hirotaka42/KiCad_UnoTypeC/Hardware/KiCad7xx_UnoTypeC/_PNG/KiCad7xx_UnoTypeC_Back.png

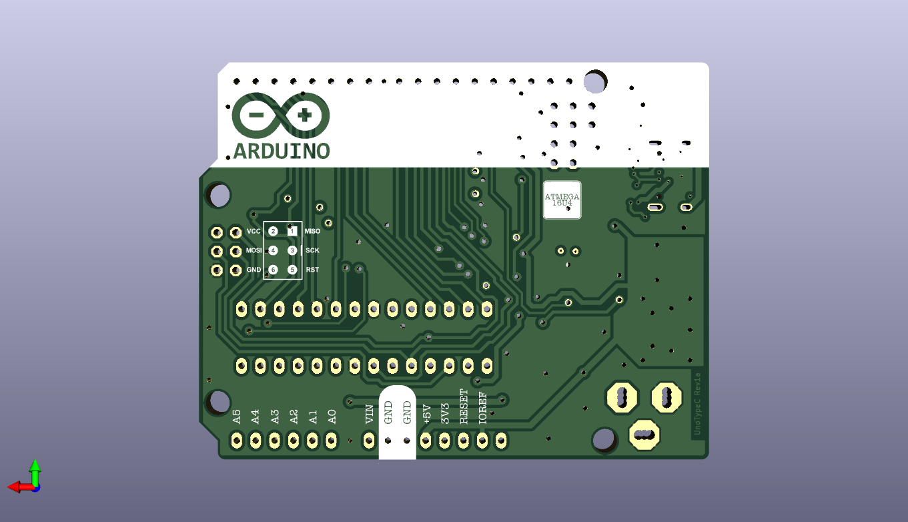
Hardware/KiCad7xx_UnoTypeC/_PNG/KiCad7xx_UnoTypeC_Back.png
