hirotaka42/KiCad_UnoTypeC/Hardware/KiCad7xx_UnoTypeC/_PNG/PCB_Back.png

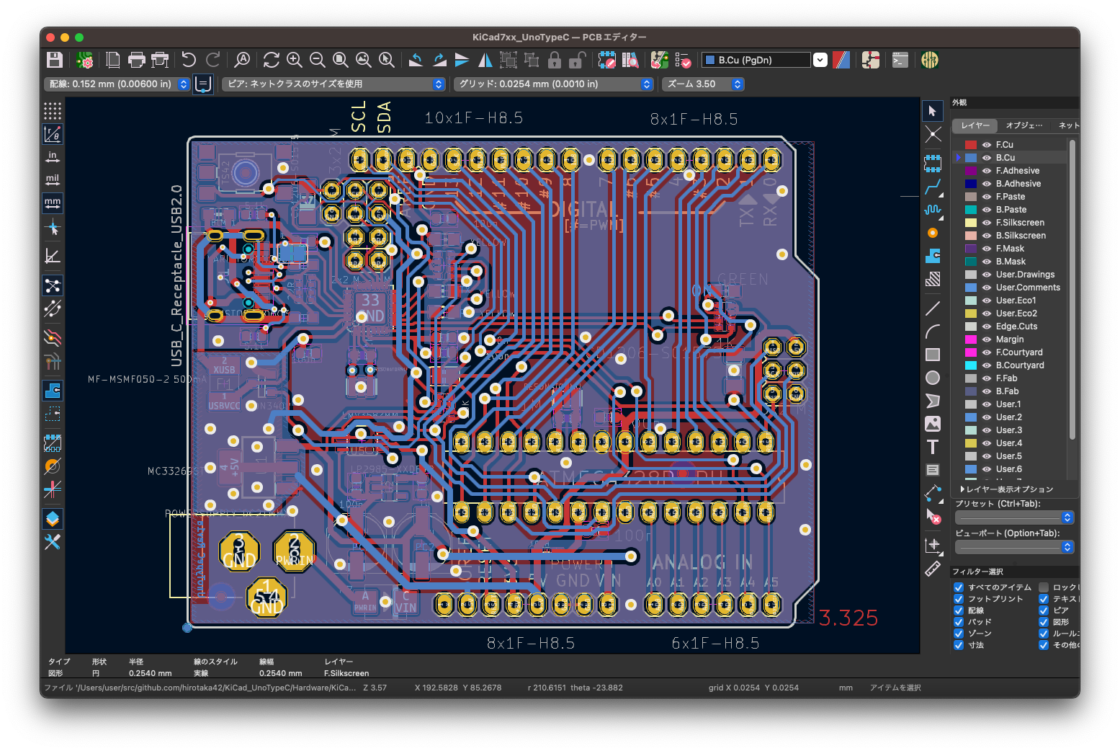
Hardware/KiCad7xx_UnoTypeC/_PNG/PCB_Back.png
