hirotaka42/KiCad_UnoTypeC/Hardware/KiCad7xx_UnoTypeC/_PNG/PCB_Front.png

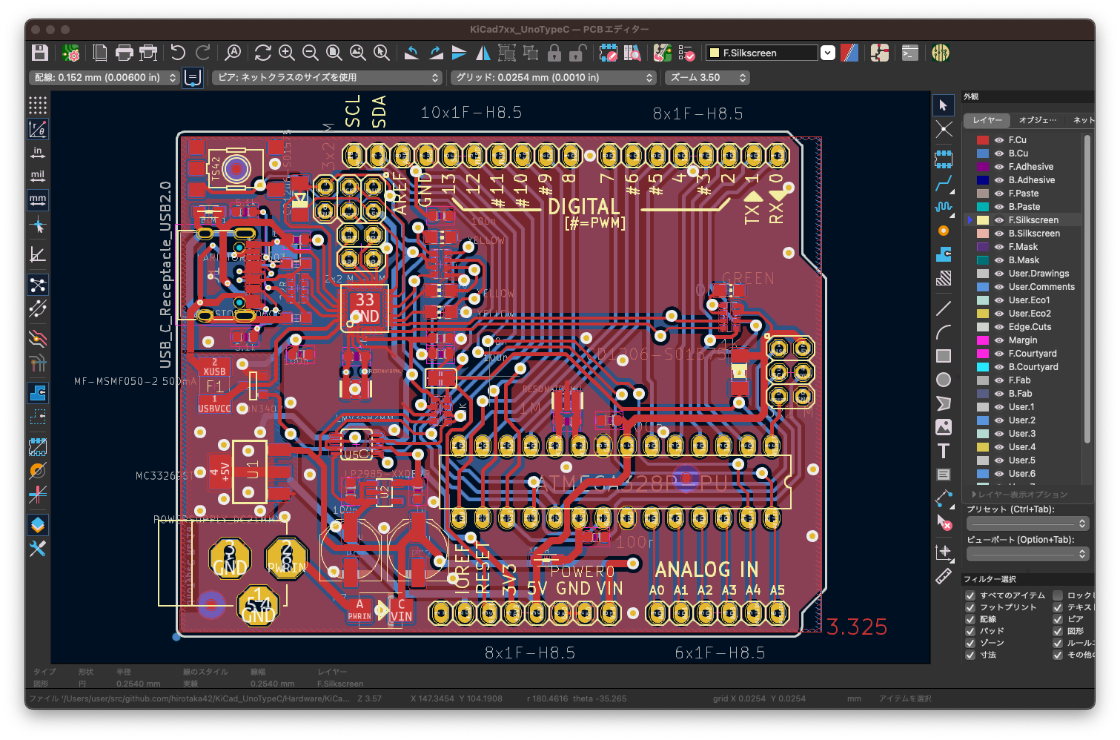
Hardware/KiCad7xx_UnoTypeC/_PNG/PCB_Front.png
