hirotaka42/KiCad_UnoTypeC/Hardware/KiCad7xx_UnoTypeC_SMD/_Adobe/シルク_Front_Rev1c.png

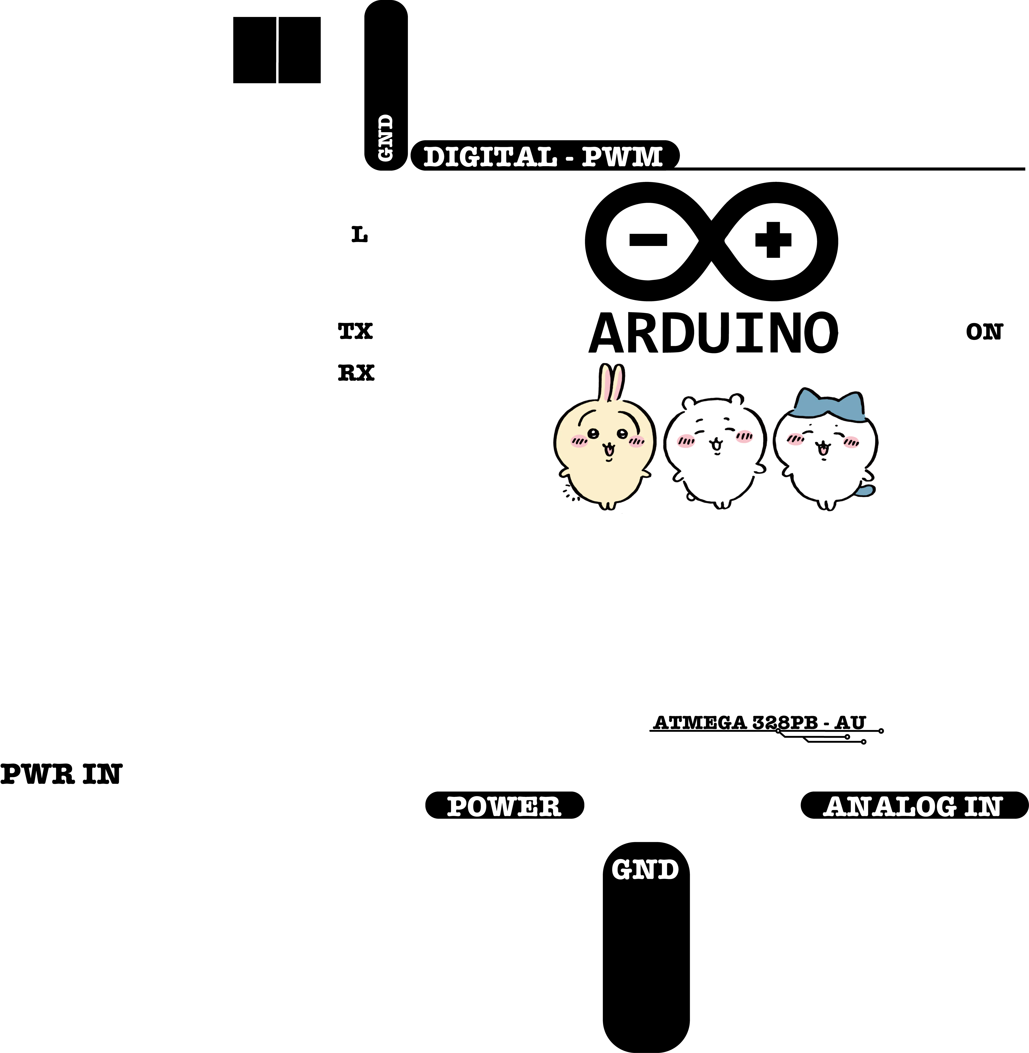
Hardware/KiCad7xx_UnoTypeC_SMD/_Adobe/シルク_Front_Rev1c.png
