hirotaka42/KiCad_UnoTypeC/Hardware/KiCad7xx_UnoTypeC_SMD/_PNG/KiCad7xx_UnoTypeC_SMD_Front.png

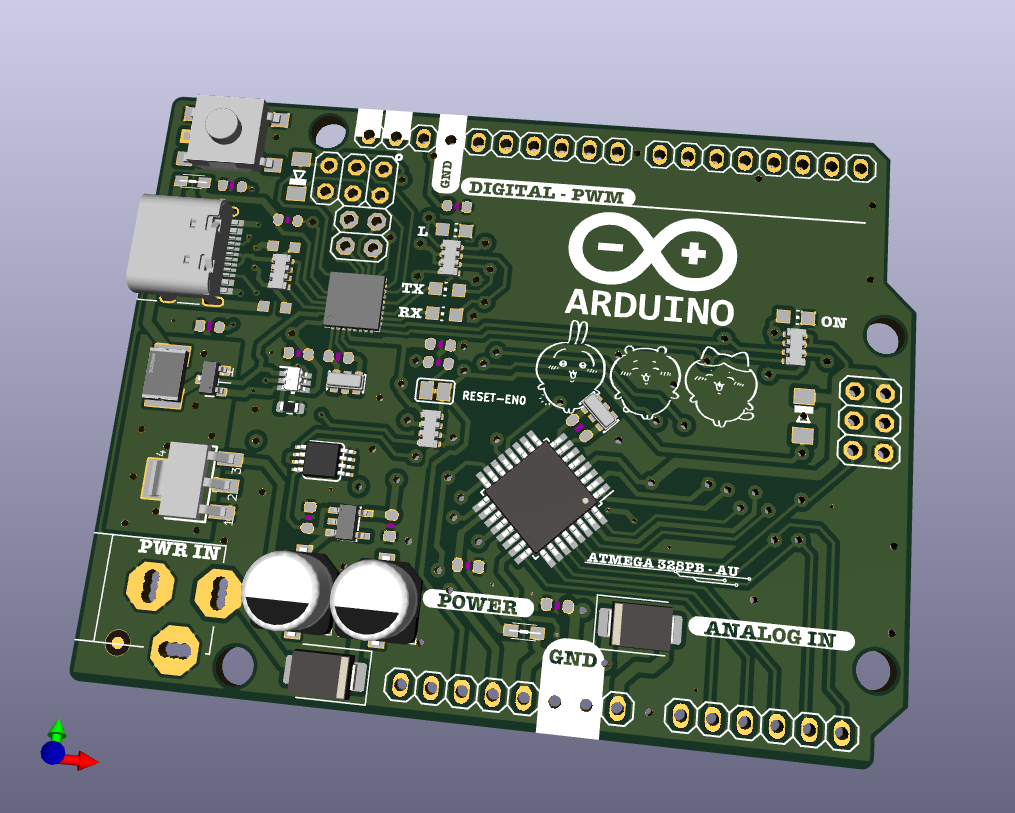
Hardware/KiCad7xx_UnoTypeC_SMD/_PNG/KiCad7xx_UnoTypeC_SMD_Front.png
