hirotaka42/KiCad_UnoTypeC/Hardware/KiCad7xx_UnoTypeC_SMD/_Adobe/material/arduino-bord.png

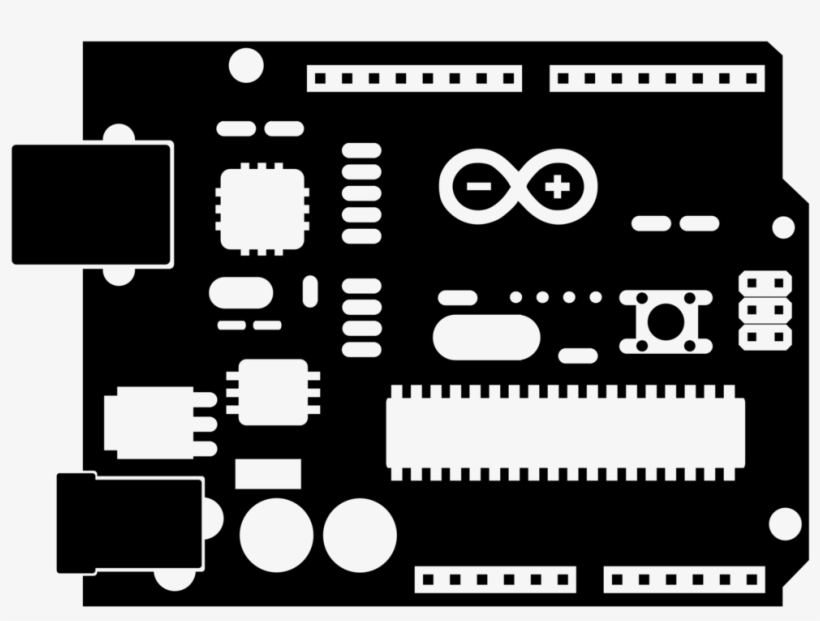
Hardware/KiCad7xx_UnoTypeC_SMD/_Adobe/material/arduino-bord.png
