hirotaka42/KiCad_UnoTypeC/(threads)

Thread 2 (2023-06-02):

KiCadプロジェクトへ変換

hirotaka42, 2023-06-02:
1.KiCadプロジェクトへ変換
2.KiCad用のパーツデータを追加
3.KiCadプロジェクトでの互換状態へ
4.KiCad版で公式Unoのガーバデータを出力

hirotaka42, 2023-06-02:
# 完了
1.KiCadプロジェクトへ変換

# 未完了
2.KiCad用のパーツデータを追加
   - フットプリントとシンボルデータの出力
3.KiCadプロジェクトでの互換状態へ
   - フットプリント上にパーツデータが3D表示されている状態
   - エレクトリカルチェックをパスできる
4.KiCad版で公式Unoのガーバデータを出力
   - シルクは未定でOK

hirotaka42, 2023-06-03:
# 未完了

4.KiCad版で公式Unoのガーバデータを出力
   - シルクは未定でOK

# 完了
1.KiCadプロジェクトへ変換
2.KiCad用のパーツデータを追加
   - フットプリントとシンボルデータの出力

3.KiCadプロジェクトでの互換状態へ
   - >フットプリント上にパーツデータが3D表示されている状態
   - エレクトリカルチェックをパスできる

hirotaka42, 2023-06-03:
# 未完了
4.KiCad版で公式Unoのガーバデータを出力
- シルクは未定でOK

ガーバーデータはこのissueでは作成していません。
Type-C基板を設計した際にReleaseか何かでまとめようかと考えています。

Closed 2023-06-03.

Thread 6 (2023-06-03):

UNOSMD_V3のTypeC基板作成

hirotaka42, 2023-06-03:
# UNOSMD_V3のTypeC基板作成

1. UNOSMD_V3(SMD(328P-AU)版)のコネクタをTypeCへ変更
2. 回路図の全体的な整理

# 前提条件
部品は可能な限り同じ構成で作成

# 変更予定
### コネクタの変更
- `USB Type-B (USB-Bコネクタ)`→`USB Type-C (USB-Cコネクタ)`

### 電源回路の見直し(逆流電流防止)

1.理想ダイオード回路の採用
2.保護ダイオードの追加
3.DCジャックを背の低いものへ変更

参考サイト
https://geekyfab.com/entry/making-universalduino

hirotaka42, 2023-06-03:
## 変更点
回路は変更せずに、TypeCコネクタを追加しました。
Type-C端子は本体が取れやすい為、半田で固定できるタイプを選択。

DX07S016JA1R1500
データシート→`SJ121836.pdf`
https://www.digikey.jp/ja/products/detail/jae-electronics/DX07S016JA1R1500/11585731

## PIN ASSIGNMENT (P.C.B PADS)

|Pad No. |1 |2 |3 |4 |5 |6 |7 |8 |9 |10 |11 |12 |
|----|----|----|----|----|----|----|----|----|----|----|----|----|
|Pin No. NAME |A1/B12 |A4/B9 |A5 |B8 |B7 | A6 |B6 |A7 | B5|A8 |B4/A9 | A12/B1 |
|SIGNAL NAME|GND |Vbus | CC1 |SBU2 |D- |D+ | D+ |D- |CC2 |SBU1 |Vbus|GND|

## 注意点
TypeCのピンアサインの並びが違うようです。
設計後確認をお願いします。

hirotaka42, 2023-06-03:
# 結論
今回はコネクタの変更のみを行いました。
未変更箇所は別プロジェクトで作成してください。
- >回路変更なしのコネクタのみ変更←今回作成したのはこっち
- 逆流防止回路を入れた修正回路版←次回作成するやつ

# 未変更

電源回路の見直し(逆流電流防止)
1.理想ダイオード回路の採用
2.保護ダイオードの追加
3.DCジャックを背の低いものへ変更

参考サイト
https://geekyfab.com/entry/making-universalduino

Closed 2023-06-03.

Thread 10 (2023-06-04):

ATMEGA328P-AU版の基板を作成

hirotaka42, 2023-06-04:
# 概要
ATMEGA328P-AU版の基板を作成
`KiCad7xx_UNOSMD_V3_TypeC_X302`

# 理由
- `KiCad7xx_UNOSMD_V3_TypeC`
- `KiCad7xx_UNOSMD_V3_TypeC_X301`

上記2枚の基板はメインコアに`ATMEGA328P-MUR`を使用しています。
ですが、`MURパッケージ`は現在(2023/06/05)入手性が非常に悪いです。
その為、秋月電子やLCSCなどで入手しやすい`AUパッケージ`版を採用します。

# 参考

|販売元|リンク|
|----|----|
|LCSC.com|[C14877](https://www.lcsc.com/product-detail/Microcontroller-Units-MCUs-MPUs-SOCs_Microchip-Tech-ATMEGA328P-AU_C14877.html)|
|秋月電子|[I-04386](https://akizukidenshi.com/catalog/g/gI-04386/)|

Closed 2023-06-04.

Thread 12 (2023-06-04):

ATMEGA328P-AU版の基板X302をベースにGrove端子を追加した基板X303を作成

hirotaka42, 2023-06-04:
# 概要
I2CのGrove端子を追加した基板X303を作成

# 前提条件
ATMEGA328P-AU版の基板[KiCad7xx_UNOSMD_V3_TypeC_X302](https://github.com/hirotaka42/KiCad_UnoTypeC/tree/dev/Hardware/KiCad7xx_UNOSMD_V3_TypeC_X302)をベースに、新規プロジェクトX303を作成する。

# 変更予定
ATMEGA328P-AU版の基板X302をベースに、
- マイコン`ATMEGA328P-AU`の未使用端子2Pinを使用したGrove端子1つ
- I2CのGrove端子1つ

合計2つのGrove端子を追加した基板X303を作成する。
最低条件として`I2CのGrove端子1つ`の実装を目標とする。

hirotaka42, 2023-06-05:
GroveコネクタのKiCadデータは以下で配布されています。
- https://github.com/orgs/Seeed-Studio/repositories?q=opl&type=all&language=&sort=
- [OPL_Connector.pretty](https://github.com/Seeed-Studio/OPL_Kicad_Library/tree/master/Seeed_Fusion_PCBA_OPL_Component_Library_for_KiCad/OPL_Connector.pretty)

X302をベースにした2層基板データではGroveコネクタを配線するスペースがありません。
その為、4層基板での設計でなければ厳しいです。
よって本issueは4層基板を設計する際に再度オープンにしてください。

該当ブランチを削除し、本issueはCloseとします。

# 該当ブランチ
- [feature-#12_CreatBoardX303WithAdditional-I2C-GrovePins](https://github.com/hirotaka42/KiCad_UnoTypeC/tree/feature-%2312_CreatBoardX303WithAdditional-I2C-GrovePins)

hirotaka42, 2023-06-05:
Groveコネクタのピンアサイン
信号名(ex,I2C) | GROVE端子 | SeedStudio版ケーブル色 | M5Stack版ケーブル色
-- | -- | -- | --
SCL | Pin1 | 黃 | 白
SDA | Pin2 | 白 | 黄
(電源/VDD) | VDD | Pin3 | 赤
(電源/GND) | GND | Pin4 | 黒

Closed 2023-06-05.

Thread 8 (2023-06-04):

UNOSMD_V3に逆流防止回路を追加する

hirotaka42, 2023-06-04:
# UNOSMD_V3の逆流防止を入れた修正回路作成

Add backflow prevention circuit to UNOSMD_V3.

# 前提条件
[KiCad7xx_UNOSMD_V3_TypeC](https://github.com/hirotaka42/KiCad_UnoTypeC/tree/dev/Hardware/KiCad7xx_UNOSMD_V3_TypeC)をベースに本目的`KiCad7xx_UNOSMD_V3_TypeC_Kai301`を作成

回路変更は以下２つを最低条件とする。
1.理想ダイオード回路の採用
2.保護ダイオードの追加

# 変更予定

## 電源回路の見直し(逆流電流防止)

1.理想ダイオード回路の採用
2.保護ダイオードの追加
3.DCジャックを背の低いものへ変更

参考サイト
https://geekyfab.com/entry/making-universalduino

# 関連issue
#6  このissueの取り残しを回収します。

Closed 2023-06-04.
