hirotaka42/KiCad_UnoTypeC/Hardware/Make/KiCad7xx_UnoTypeC.pdf

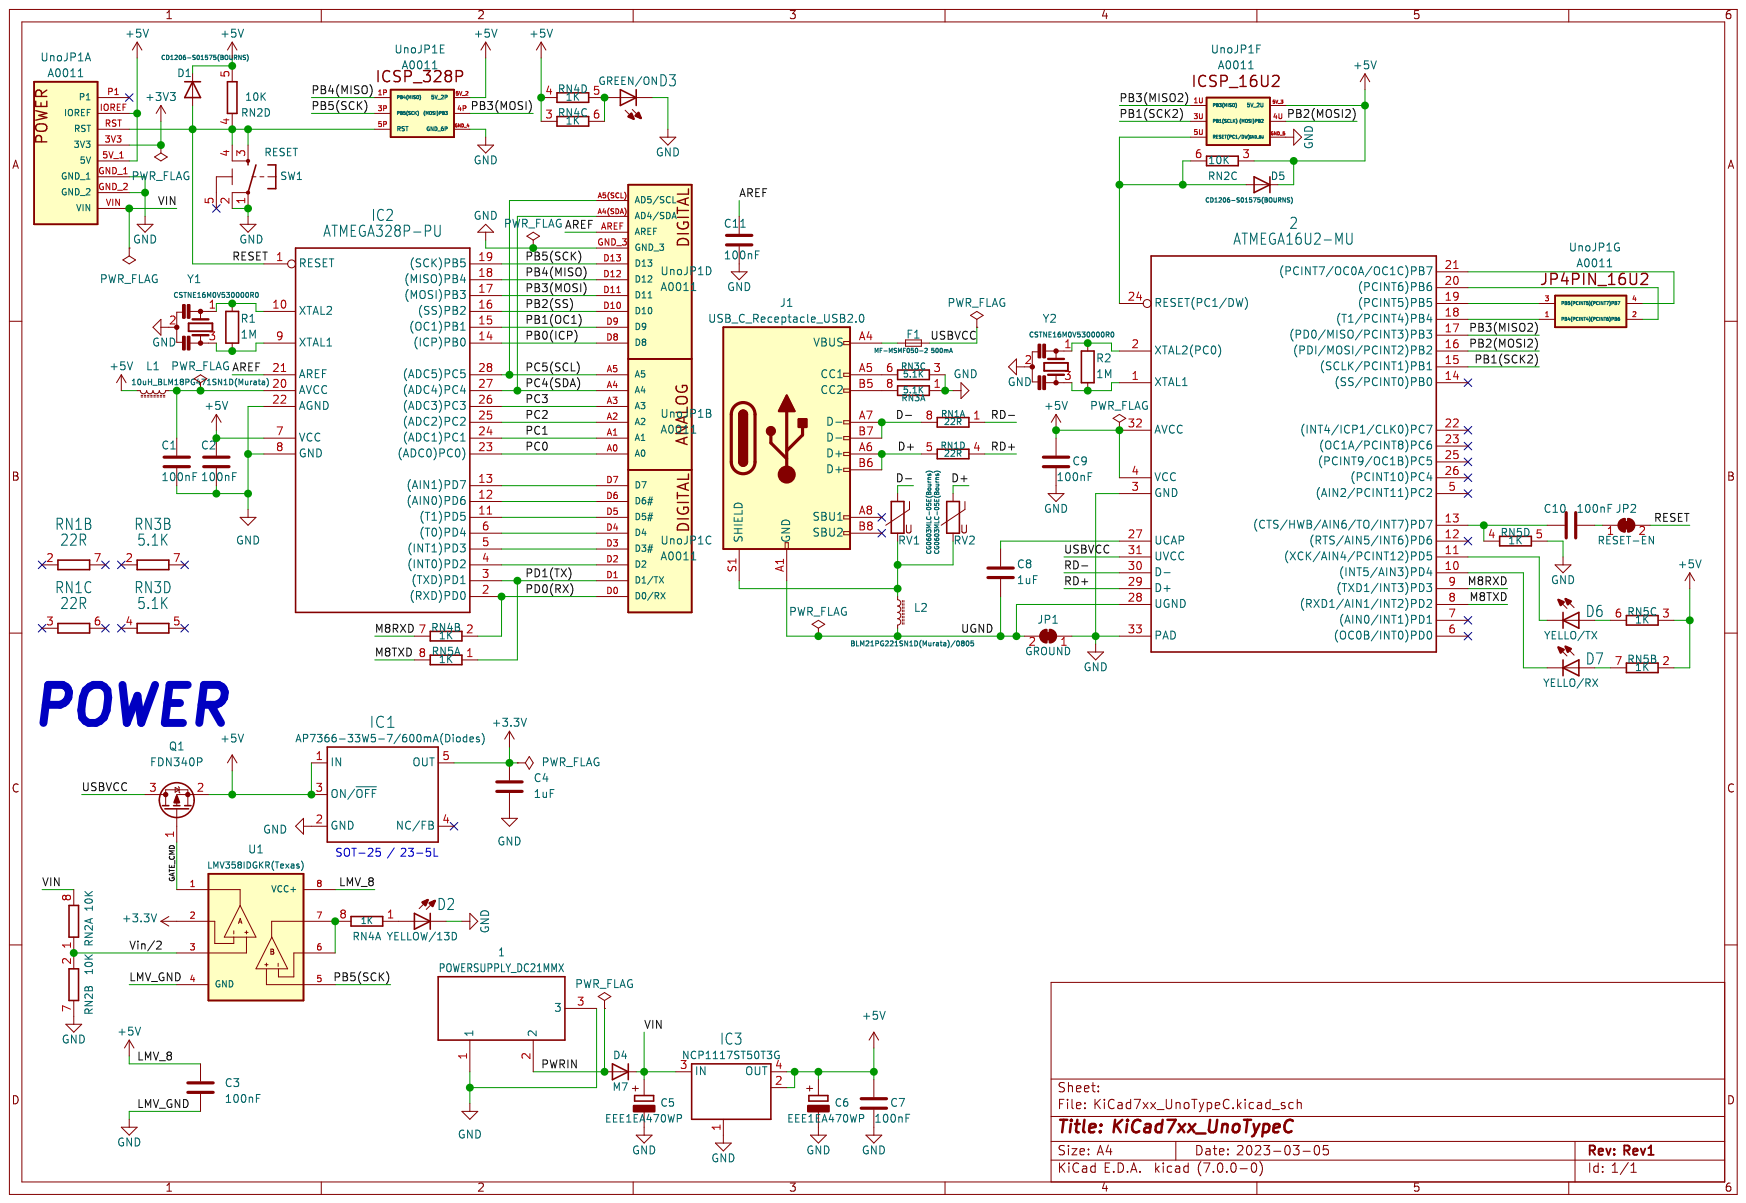
[picture p13: page 1]
