hirotaka42/KiCad_UnoTypeC/Hardware/KiCad7xx_UnoTypeC/_Sch/KiCad7xx_UnoTypeC.pdf

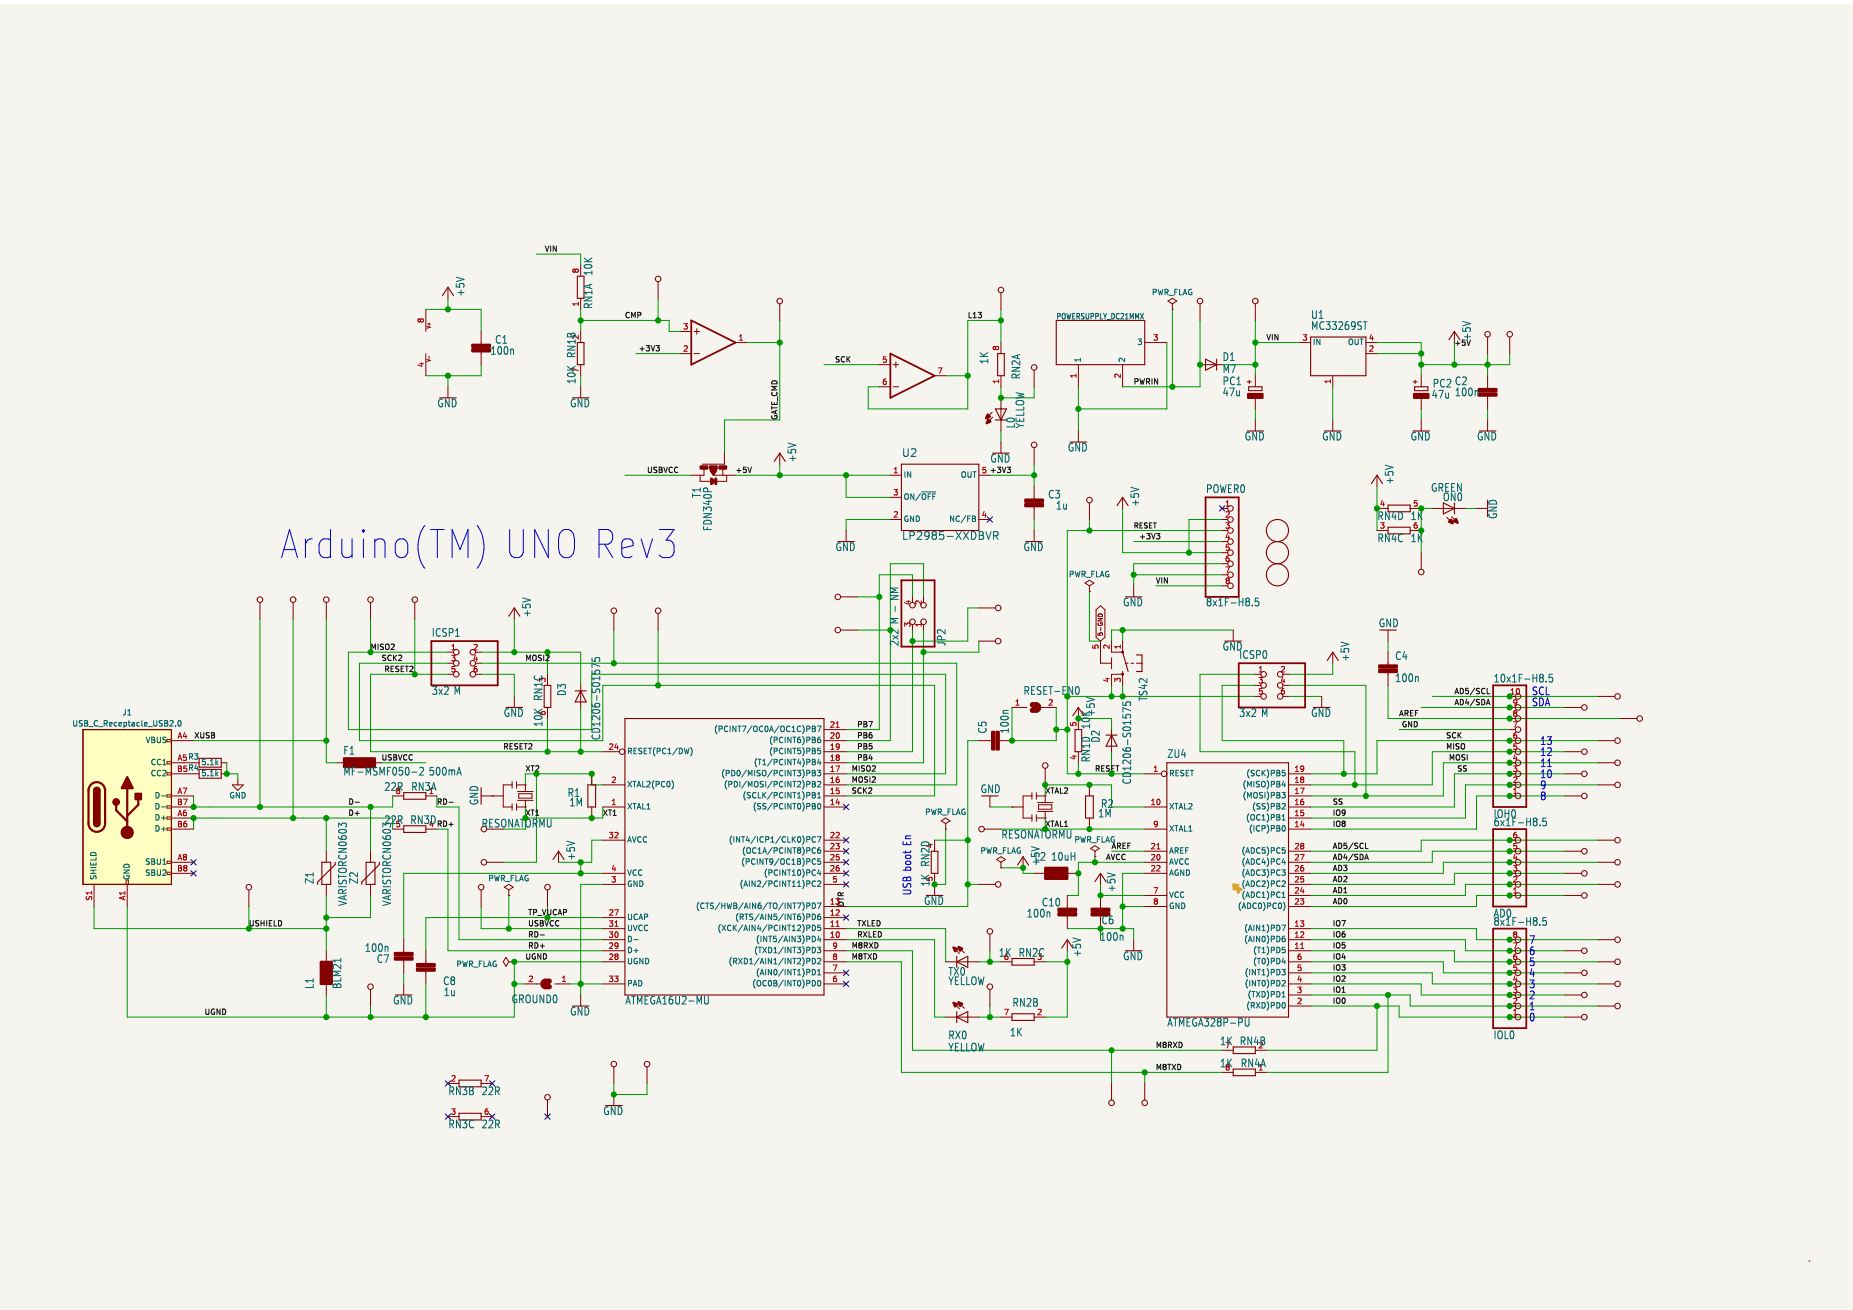
[picture p14: page 1]
