hirotaka42/KiCad_UnoTypeC/Hardware/KiCad7xx_UnoTypeC_SMD/KiCad7xx_UnoTypeC_SMD.kicad_pcb

## KiCad design Hardware/KiCad7xx_UnoTypeC_SMD/KiCad7xx_UnoTypeC_SMD.kicad_pcb (2023-03-10)

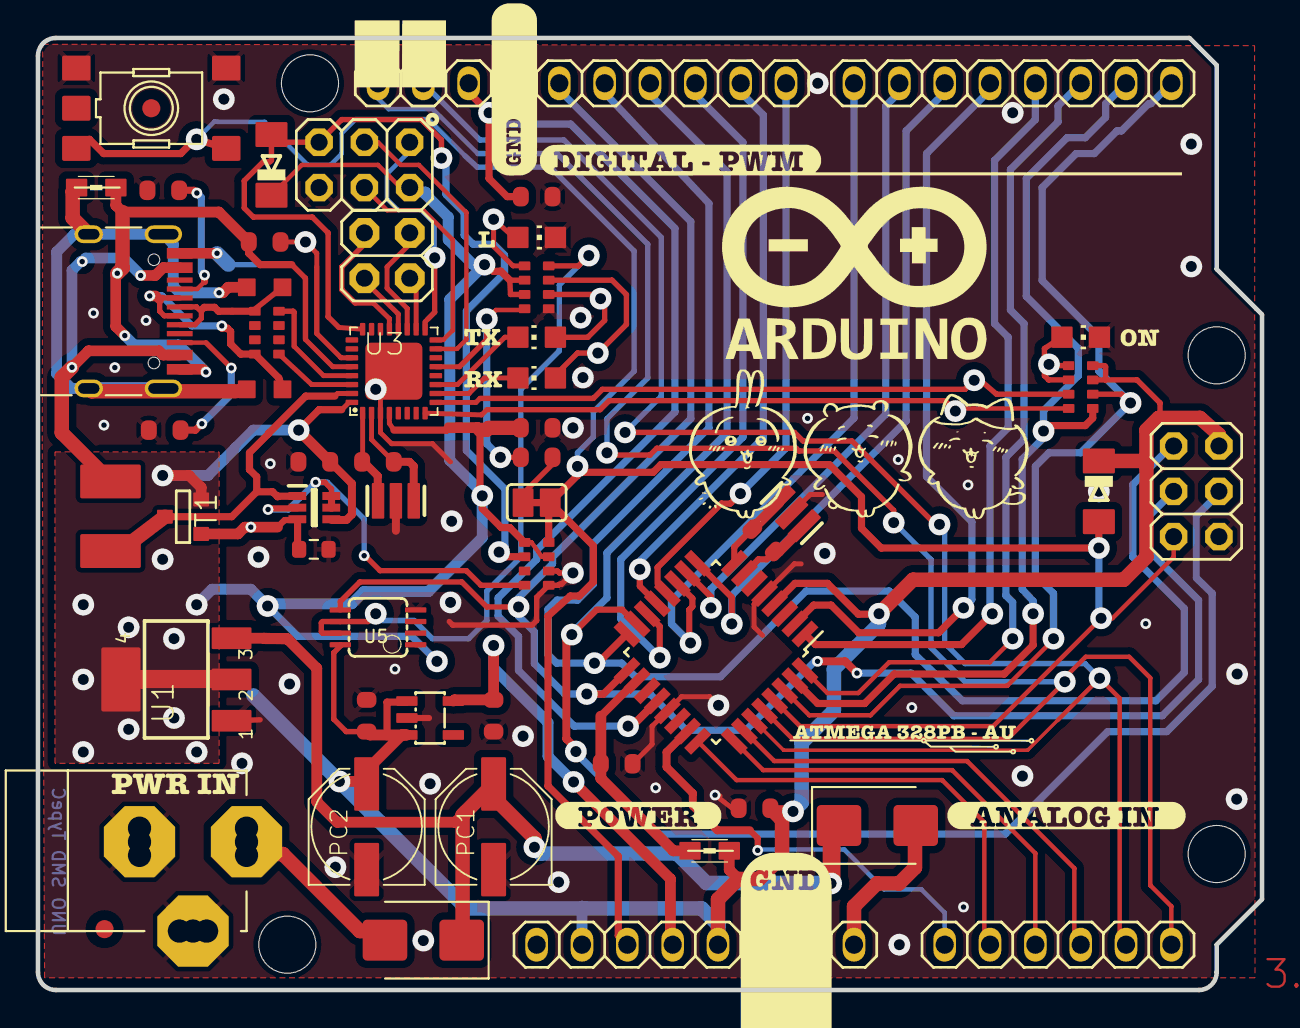
[picture p15: board KiCad7xx_UnoTypeC_SMD.kicad_pcb from above]

Board: 2 copper layers, 68.6 x 53.3 mm, 73 parts (1 on the bottom side), 64 nets.

Parts:
C1, C2, C4, C5, C6, C7: 100n; C0603-ROUND
C3, C8: 1u; C0603-ROUND
C9: 100nF; C0603-ROUND
D1, D4: SS54B (FOSAN); D_SMB
D2, D3: CD1206-S01575; MINIMELF
F1: MF-MSMF110/16-2A; L1812
FD1, FD3: FIDUCIAL-1.5MM; FD-1-1.5
GROUND0: SJ
H1, H2, H3, H4: MountingHole; MountingHole_3.2mm_M3_ISO14580
ICSP0, ICSP1: 3x2 M; 2X03
J1: -; 1X14-CUSTOM
J2: PINHD-1X18; 1X18-CUSTOM
J3: USB_C_Receptacle_USB2.0; USB_C_Receptacle_HRO_TYPE-C-31-M-12
JP2: 2x2 M-NM; 2X02
L0: YELLOW; CHIP-LED0805
L1: BLM21; 0805
L2: 10uH; 0805
ON0: GREEN; CHIP-LED0805
ORIGIN0: TP_SP; TP-SP
PC1, PC2: 47u; PANASONIC_D
R1, R2: 1M; R0603-ROUND
R3, R4: 5.1k; R0603-ROUND
R5: 47K; R_0603_1608Metric
RESET0: TS42
RESET-EN0: SJ
RN1: 10K; CAY16
RN2, RN4: 1K; CAY16
RN3: 22R; CAY16
RX0: YELLOW; CHIP-LED0805
T1: PMOS/FDN340P(onsemi)/2A; SOT-23
TP_5V1: TP_SP; TP-SP
TP_DTR0: TP_SP; TP-SP
TP_LCMD0: TP_SP; TP-SP
TP_LL0: TP_SP; TP-SP
TP_MISO2: TP_SP; TP-SP
TP_MOSI2: TP_SP; TP-SP
TP_ONL0: TP_SP; TP-SP
TP_RESET2: TP_SP; TP-SP
TP_RX0: TP_SP; TP-SP
TP_RXL0: TP_SP; TP-SP
TP_SCK2: TP_SP; TP-SP
TP_TX0: TP_SP; TP-SP
TP_TXL0: TP_SP; TP-SP
TP_VUCAP0: TP_SP; TP-SP
TX0: YELLOW; CHIP-LED0805
U1: MC33269ST; SOT223
U2: LP2985-XXDBVR; SOT23-DBV
U3: ATMEGA16U2; ATMEL_QFN32
U4: ATmega328PB-A; TQFP-32_7x7mm_P0.8mm
U5: LMV358IDGKR; MSOP08
U6: BCM857BS; SOT65P210X110-6N
X1: POWERSUPPLY_DC21MMX; POWERSUPPLY_DC-21MM
Y1, Y2: RESONATORMU; RESONATOR
Z1, Z2: VARISTORCN0603; CT_CN0603

Connections:
+3.3V: C3.2, J1.4, U2.5 (OUT)
+5V: C1.2, C2.2, C6.2, C7.1, D2.C, D3.C, ICSP0.2, ICSP1.2, J1.2, J1.5, L2.1, PC2.+, RN1.3 (1), RN1.5 (2), RN2.2 (1), RN2.3 (1), RN4.3 (1), RN4.4 (1), T1.2 (S), TP_5V1.X (TESTP), U1.2 (OUT@1), U1.4 (OUT), U2.1 (IN), U2.3 (ON/~OFF), U3.4 (VCC), U3.32 (AVCC), U4.4 (VCC), U5.8 (VCC+), U6.4
/A0: J1.9, U4.23 (PC0)
/A1: J1.10, U4.24 (PC1)
/A2: J1.11, U4.25 (PC2)
/A3: J1.12, U4.26 (PC3)
/A4/SDA: J1.13, J2.17, U4.27 (PC4)
/A5/SCL: J1.14, J2.18, U4.28 (PC5)
/AREF: C4.2, J2.16, U4.20 (AREF)
/AVCC: C9.1, L2.2, U4.18 (AVCC)
/D+: J3.A6 (D+), J3.B6 (D+), RN3.5 (2), Z1.1
/D-: J3.A7 (D-), J3.B7 (D-), RN3.8 (2), Z2.1
/DTR: C5.1, RN2.4 (1), TP_DTR0.X (TESTP), U3.13 ((CTS/HWB/AIN6/TO/INT7)PD7)
/IO0: J2.1, RN4.2 (1), U4.30 (PD0)
/IO1: J2.2, RN4.1, U4.31 (PD1)
/IO2: J2.3, U4.32 (PD2)
/IO3: J2.4, U4.1 (PD3)
/IO4: J2.5, U4.2 (PD4)
/IO5: J2.6, U4.9 (PD5)
/IO6: J2.7, U4.10 (PD6)
/IO7: J2.8, U4.11 (PD7)
/IO8: J2.9, U4.12 (PB0)
/IO9: J2.10, U4.13 (PB1)
/L13: RN2.8 (2), TP_LCMD0.X (TESTP), U5.6, U5.7
/M8RXD: RN4.7 (2), TP_RX0.X (TESTP), U3.9 ((TXD1/INT3)PD3)
/M8TXD: RN4.8 (2), TP_TX0.X (TESTP), U3.8 ((RXD1/AIN1/INT2)PD2)
/MISO: ICSP0.1, J2.13, U4.16 (PB4)
/MISO2: ICSP1.1, TP_MISO2.X (TESTP), U3.17 ((PD0/MISO/PCINT3)PB3)
/MOSI: ICSP0.4, J2.12, U4.15 (PB3)
/MOSI2: ICSP1.4, TP_MOSI2.X (TESTP), U3.16 ((PDI/MOSI/PCINT2)PB2)
/PB4: JP2.1, U3.18 ((T1/PCINT4)PB4)
/PB5: JP2.3, U3.19 ((PCINT5)PB5)
/PB6: JP2.2, U3.20 ((PCINT6)PB6)
/PB6/XTAL1: R2.1, U4.7 (XTAL1/PB6), Y2.3
/PB7: JP2.4, U3.21 ((PCINT7/OC0A/OC1C)PB7)
/PB7/XTAL2: R2.2, U4.8 (XTAL2/PB7), Y2.1
/PC6/RESET: C5.2, D2.A, ICSP0.5, J1.3, RESET0.3, RESET0.4, RESET-EN0.1, RESET-EN0.2, RN1.4 (1), U4.29 (~RESET/PC6)
/PWRIN: D1.2 (A), X1.1
/RD+: RN3.4 (1), U3.29 (D+)
/RD-: RN3.1, U3.30 (D-)
/RESET2: D3.A, ICSP1.5, RN1.6 (2), TP_RESET2.X (TESTP), U3.24 (RESET(PC1/DW))
/RXLED: RX0.C, U3.10 ((INT5/AIN3)PD4)
/SCK: ICSP0.3, J2.14, U4.17 (PB5), U5.5
/SCK2: ICSP1.3, TP_SCK2.X (TESTP), U3.15 ((SCLK/PCINT1)PB1)
/SS: J2.11, U4.14 (PB2)
/TP_VUCAP: C8.1, TP_VUCAP0.X (TESTP), U3.27 (UCAP)
/TXLED: TX0.C, U3.11 ((XCK/AIN4/PCINT12)PD5)
/UGND: C8.2, GROUND0.2, J3.A1 (GND), J3.A12 (GND), J3.B1 (GND), J3.B12 (GND), L1.1, U3.28 (UGND)
/USBVCC: F1.1, T1.1 (D), U3.31 (UVCC), U6.1
/USHIELD: J3.S1 (SHIELD), L1.2, Z1.2, Z2.2
/VIN: D4.2 (A), J1.8
/XT1: R1.1, U3.1 (XTAL1), Y1.3
/XT2: R1.2, U3.2 (XTAL2(PC0)), Y1.1
/XUSB: F1.2, J3.A4 (VBUS), J3.A9 (VBUS), J3.B4 (VBUS), J3.B9 (VBUS)
GND: C1.1, C2.1, C3.1, C4.1, C6.1, C7.2, C9.2, GROUND0.1, ICSP0.6, ICSP1.6, J1.6, J1.7, J2.15, L0.C, ON0.C, PC1.-, PC2.-, R3.1, R4.1, R5.2, RESET0.1, RESET0.2, RN1.1, RN2.5 (2), U1.1 (GND/ADJ), U2.2 (GND), U3.3 (GND), U3.EXP (PAD), U4.5 (GND), U4.21 (GND), U5.4 (GND), X1.2, X1.3, Y1.2, Y2.2
unnamed: J3.A5 (CC1), R3.2
unnamed: J3.B5 (CC2), R4.2
unnamed: RN1.8 (2), U6.2, U6.5, U6.6
unnamed: RN2.7 (2), RX0.A, TP_RXL0.X (TESTP)
unnamed: RN2.6 (2), TP_TXL0.X (TESTP), TX0.A
unnamed: ON0.A, RN4.5 (2), RN4.6 (2), TP_ONL0.X (TESTP)
unnamed: R5.1, T1.3 (G), U6.3
unnamed: L0.A, RN2.1, TP_LL0.X (TESTP)
VCC: D1.1 (K), D4.1 (K), PC1.+, U1.3 (IN)
