hirotaka42/KiCad_UnoTypeC/Hardware/KiCad7xx_UnoTypeC/KiCad7xx_UnoTypeC.kicad_pcb

## KiCad design Hardware/KiCad7xx_UnoTypeC/KiCad7xx_UnoTypeC.kicad_pcb (2023-03-07)

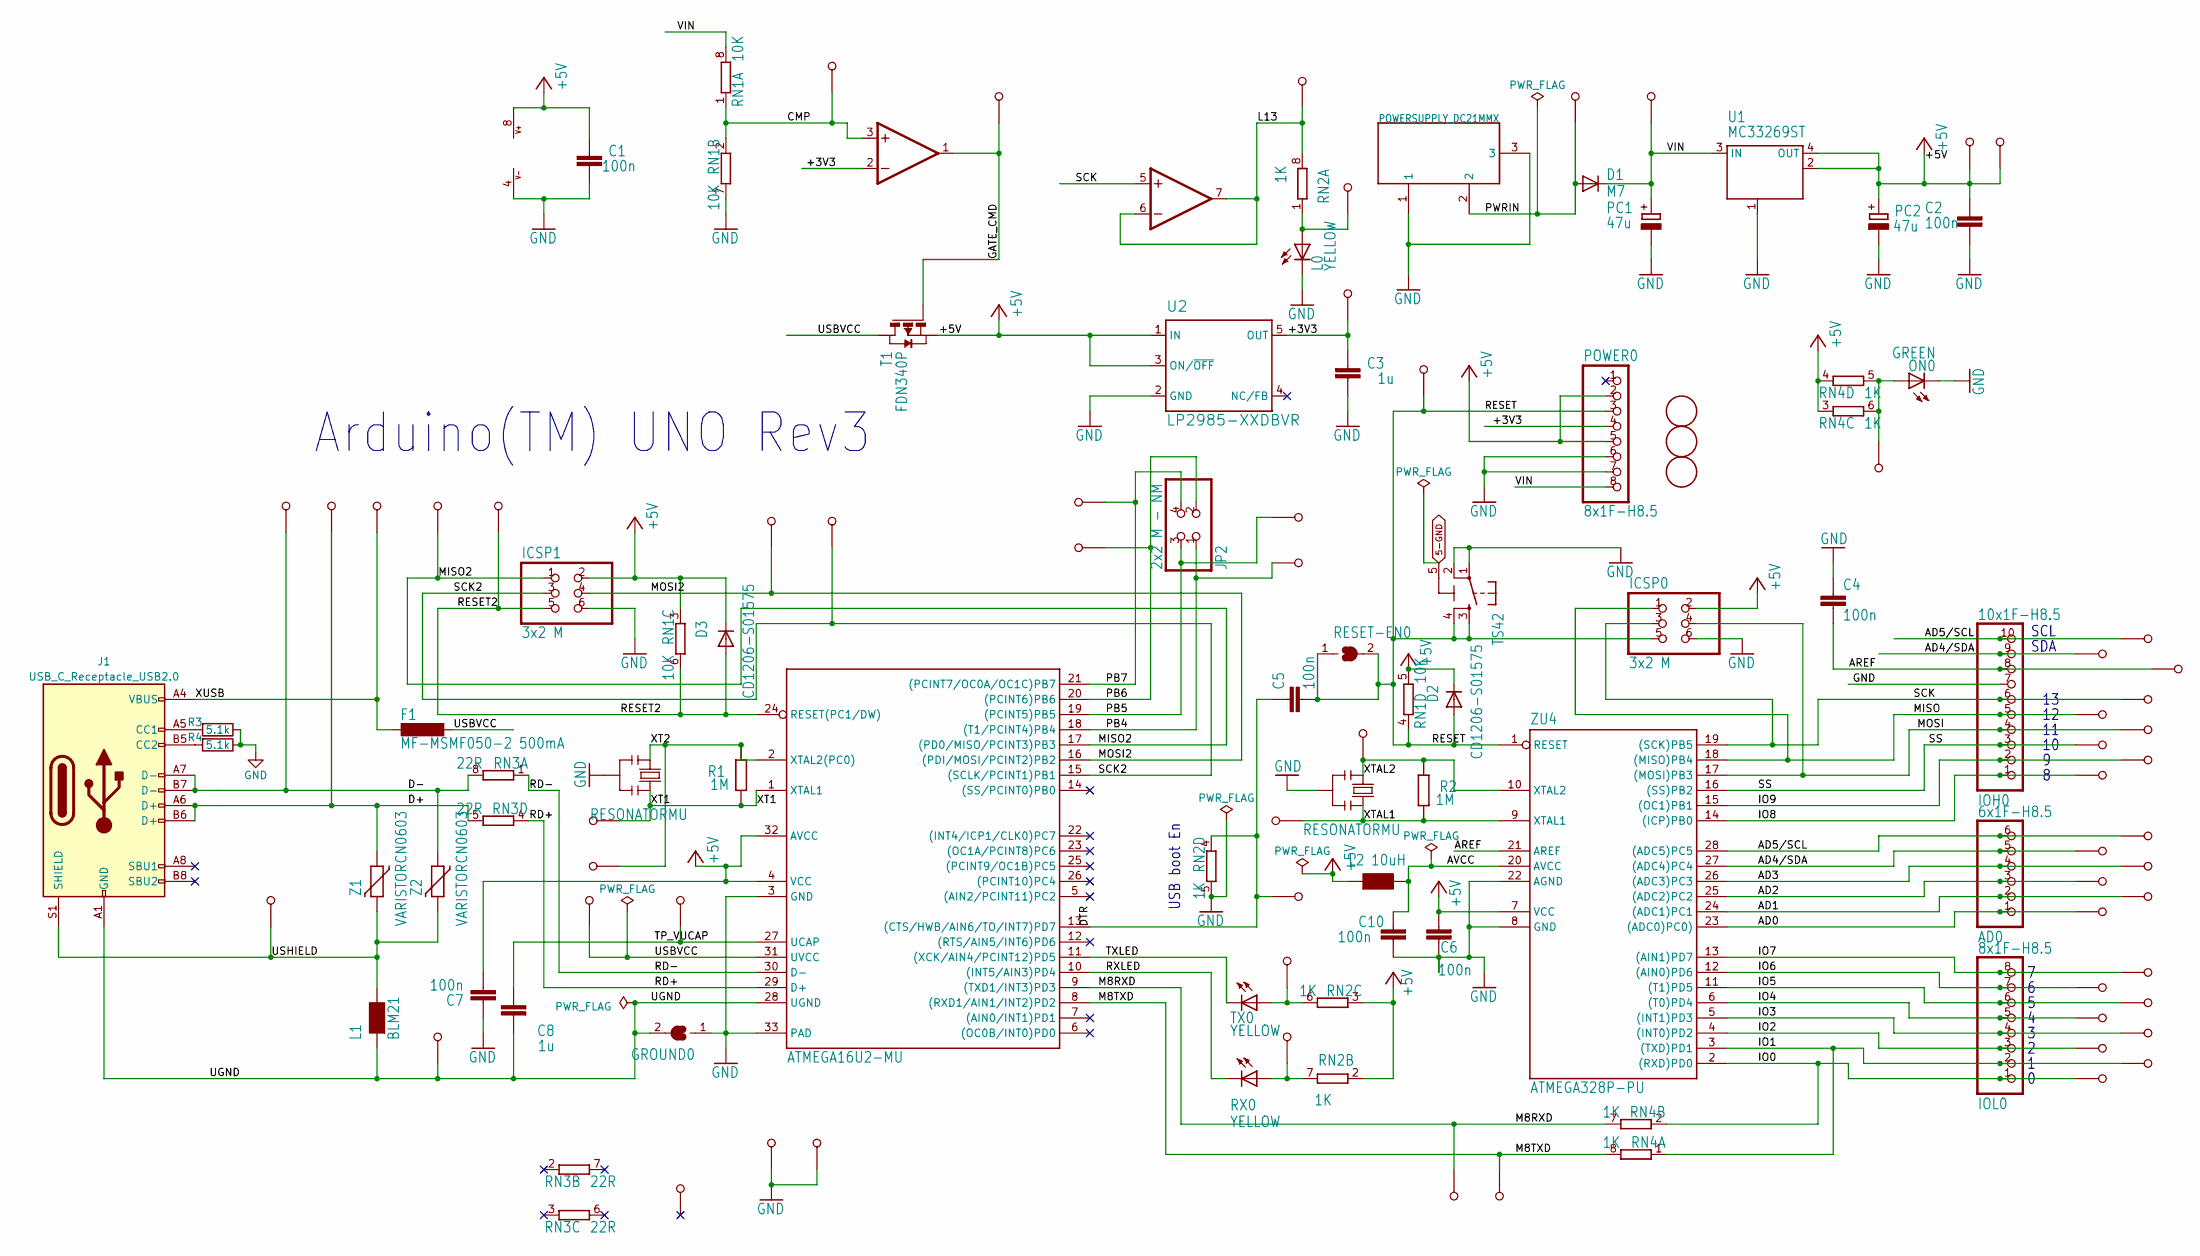
[picture p16: schematic KiCad7xx_UnoTypeC.kicad_sch]

Parts:
AD0: 6x1F-H8.5; 1X06
C1, C2, C4, C5, C6, C7, C10: 100n; C0603-ROUND
C3, C8: 1u; C0603-ROUND
D1: M7; SMB
D2, D3: CD1206-S01575; MINIMELF
F1: MF-MSMF050-2 500mA; L1812
FD1, FD2, FD3: FIDUCIALMOUNT; FIDUCIA-MOUNT
GND_TP0, GND_TP1: TP_SP; TP-SP
GROUND0: SJ
ICSP0, ICSP1: 3x2 M; 2X03
IOH0: 10x1F-H8.5; 1X10
IOL0: 8x1F-H8.5; 1X08
J1: USB_C_Receptacle_USB2.0; USB_C_Receptacle_HRO_TYPE-C-31-M-12
JP2: 2x2 M - NM; 2X02
L0: YELLOW; CHIP-LED0805
L1: BLM21; 0805
L2: 10uH; 0805
ON0: GREEN; CHIP-LED0805
ORIGIN0: TP_SP; TP-SP
PC1, PC2: 47u; PANASONIC_D
POWER0: 8x1F-H8.5; 1X08
R1, R2: 1M; R0603-ROUND
R3, R4: 5.1k; R0603-ROUND
RESET0: TS42
RESET-EN0: SJ
RN1: 10K; CAY16
RN2, RN4: 1K; CAY16
RN3: 22R; CAY16
RX0: YELLOW; CHIP-LED0805
T1: FDN340P; SOT-23
TP_0, TP_1, TP_2, TP_3, TP_3V3, TP_4, TP_5, TP_5V0, TP_5V1, TP_6, TP_7, TP_8, TP_9, TP_10, TP_11, TP_12, TP_13: TP_SP; TP-SP
TP_A0, TP_A1, TP_A2, TP_A3, TP_A4, TP_A5: TP_SP; TP-SP
TP_AREF0: TP_SP; TP-SP
TP_CMP0: TP_SP; TP-SP
TP_D+0: TP_SP; TP-SP
TP_D-0: TP_SP; TP-SP
TP_DTR0: TP_SP; TP-SP
TP_GATE0: TP_SP; TP-SP
TP_LCMD0: TP_SP; TP-SP
TP_LL0: TP_SP; TP-SP
TP_MISO2: TP_SP; TP-SP
TP_MOSI2: TP_SP; TP-SP
TP_ONL0: TP_SP; TP-SP
TP_PB4, TP_PB5, TP_PB6, TP_PB7: TP_SP; TP-SP
TP_PWRIN0: TP_SP; TP-SP
TP_RESET0, TP_RESET2: TP_SP; TP-SP
TP_RX0: TP_SP; TP-SP
TP_RXL0: TP_SP; TP-SP
TP_SCK2: TP_SP; TP-SP
TP_SCL0: TP_SP; TP-SP
TP_SDA0: TP_SP; TP-SP
TP_TX0: TP_SP; TP-SP
TP_TXL0: TP_SP; TP-SP
TP_UGND0: TP_SP; TP-SP
TP_USBVCC0: TP_SP; TP-SP
TP_USH0: TP_SP; TP-SP
TP_VIN0: TP_SP; TP-SP
TP_VUCAP0: TP_SP; TP-SP
TP_XT1, TP_XT2, TP_XT3, TP_XT4: TP_SP; TP-SP
TP_XUSB0: TP_SP; TP-SP
TX0: YELLOW; CHIP-LED0805
U1: MC33269ST; SOT223
U2: LP2985-XXDBVR; SOT23-DBV
U3: ATMEGA16U2-MU; MLF32
U5: LMV358?MM; MSOP08
X1: POWERSUPPLY_DC21MMX; POWERSUPPLY_DC-21MM
Y1, Y2: RESONATORMU; RESONATOR
Z1, Z2: VARISTORCN0603; CT_CN0603
ZU4: ATMEGA328P-PU; DIL28-3

Connections:
5-GND: RESET0.5 (5-GND)
+5V: C1.2, C2.2, C6.2, C7.1, D2.C, D3.C, ICSP0.2, ICSP1.2, L2.1, PC2.+, POWER0.2, POWER0.5, RN1.3 (1), RN1.5 (2), RN2.2 (1), RN2.3 (1), RN4.3 (1), RN4.4 (1), T1.2 (S), TP_5V0.X (TESTP), TP_5V1.X (TESTP), U1.2 (OUT@1), U1.4 (OUT), U2.1 (IN), U2.3 (ON/~OFF), U3.4 (VCC), U3.32 (AVCC), U5.8 (V+), ZU4.7 (VCC)
/+3V3: C3.2, POWER0.4, TP_3V3.X (TESTP), U2.5 (OUT), U5.2 (-IN)
/AD0: AD0.1, TP_A0.X (TESTP), ZU4.23 ((ADC0)PC0))
/AD1: AD0.2, TP_A1.X (TESTP), ZU4.24 ((ADC1)PC1)
/AD2: AD0.3, TP_A2.X (TESTP), ZU4.25 ((ADC2)PC2)
/AD3: AD0.4, TP_A3.X (TESTP), ZU4.26 ((ADC3)PC3)
/AD4/SDA: AD0.5, IOH0.9, TP_A4.X (TESTP), TP_SDA0.X (TESTP), ZU4.27 ((ADC4)PC4)
/AD5/SCL: AD0.6, IOH0.10, TP_A5.X (TESTP), TP_SCL0.X (TESTP), ZU4.28 ((ADC5)PC5)
/AREF: C4.2, IOH0.8, TP_AREF0.X (TESTP), ZU4.21 (AREF)
/AVCC: C10.2, L2.2, ZU4.20 (AVCC)
/CMP: RN1.1, RN1.2 (1), TP_CMP0.X (TESTP), U5.3 (+IN)
/D+: J1.A6 (D+), J1.B6 (D+), RN3.5 (2), TP_D+0.X, Z1.1
/D-: J1.A7 (D-), J1.B7 (D-), RN3.8 (2), TP_D-0.X, Z2.1
/DTR: C5.1, RN2.4 (1), TP_DTR0.X (TESTP), U3.13 ((CTS/HWB/AIN6/TO/INT7)PD7)
/GATE_CMD: T1.3 (G), TP_GATE0.X (TESTP), U5.1 (OUT)
/IO0: IOL0.1, RN4.2 (1), TP_0.X (TESTP), ZU4.2 ((RXD)PD0)
/IO1: IOL0.2, RN4.1, TP_1.X (TESTP), ZU4.3 ((TXD)PD1)
/IO2: IOL0.3, TP_2.X (TESTP), ZU4.4 ((INT0)PD2)
/IO3: IOL0.4, TP_3.X (TESTP), ZU4.5 ((INT1)PD3)
/IO4: IOL0.5, TP_4.X (TESTP), ZU4.6 ((T0)PD4)
/IO5: IOL0.6, TP_5.X (TESTP), ZU4.11 ((T1)PD5)
/IO6: IOL0.7, TP_6.X (TESTP), ZU4.12 ((AIN0)PD6)
/IO7: IOL0.8, TP_7.X (TESTP), ZU4.13 ((AIN1)PD7)
/IO8: IOH0.1, TP_8.X (TESTP), ZU4.14 ((ICP)PB0)
/IO9: IOH0.2, TP_9.X (TESTP), ZU4.15 ((OC1)PB1)
/L13: RN2.8 (2), TP_LCMD0.X (TESTP), U5.6 (-IN), U5.7 (OUT)
/M8RXD: RN4.7 (2), TP_RX0.X (TESTP), U3.9 ((TXD1/INT3)PD3)
/M8TXD: RN4.8 (2), TP_TX0.X (TESTP), U3.8 ((RXD1/AIN1/INT2)PD2)
/MISO: ICSP0.1, IOH0.5, TP_12.X (TESTP), ZU4.18 ((MISO)PB4)
/MISO2: ICSP1.1, TP_MISO2.X (TESTP), U3.17 ((PD0/MISO/PCINT3)PB3)
/MOSI: ICSP0.4, IOH0.4, TP_11.X (TESTP), ZU4.17 ((MOSI)PB3)
/MOSI2: ICSP1.4, TP_MOSI2.X (TESTP), U3.16 ((PDI/MOSI/PCINT2)PB2)
/PB4: JP2.1, TP_PB4.X (TESTP), U3.18 ((T1/PCINT4)PB4)
/PB5: JP2.3, TP_PB5.X (TESTP), U3.19 ((PCINT5)PB5)
/PB6: JP2.2, TP_PB6.X (TESTP), U3.20 ((PCINT6)PB6)
/PB7: JP2.4, TP_PB7.X (TESTP), U3.21 ((PCINT7/OC0A/OC1C)PB7)
/PWRIN: D1.A, TP_PWRIN0.X (TESTP), X1.2
/RD+: RN3.4 (1), U3.29 (D+)
/RD-: RN3.1, U3.30 (D-)
/RESET: C5.2, D2.A, ICSP0.5, POWER0.3, RESET0.3, RESET0.4, RESET-EN0.1, RESET-EN0.2, RN1.4 (1), TP_RESET0.X (TESTP), ZU4.1 (RESET)
/RESET2: D3.A, ICSP1.5, RN1.6 (2), TP_RESET2.X (TESTP), U3.24 (RESET(PC1/DW))
/RXLED: RX0.C, U3.10 ((INT5/AIN3)PD4)
/SCK: ICSP0.3, IOH0.6, TP_13.X (TESTP), U5.5 (+IN), ZU4.19 ((SCK)PB5)
/SCK2: ICSP1.3, TP_SCK2.X (TESTP), U3.15 ((SCLK/PCINT1)PB1)
/SS: IOH0.3, TP_10.X (TESTP), ZU4.16 ((SS)PB2)
/TP_VUCAP: C8.1, TP_VUCAP0.X (TESTP), U3.27 (UCAP)
/TXLED: TX0.C, U3.11 ((XCK/AIN4/PCINT12)PD5)
/USBVCC: F1.1, T1.1 (D), TP_USBVCC0.X, U3.31 (UVCC)
/USHIELD: J1.S1 (SHIELD), L1.2, TP_USH0.X, Z1.2, Z2.2
/VIN: D1.C, PC1.+, POWER0.8, RN1.8 (2), TP_VIN0.X (TESTP), U1.3 (IN)
/XT1: R1.1, TP_XT3.X (TESTP), U3.1 (XTAL1), Y1.3
/XT2: R1.2, TP_XT4.X (TESTP), U3.2 (XTAL2(PC0)), Y1.1
/XTAL1: R2.1, TP_XT1.X (TESTP), Y2.3, ZU4.9 (XTAL1)
/XTAL2: R2.2, TP_XT2.X (TESTP), Y2.1, ZU4.10 (XTAL2)
/XUSB: F1.2, J1.A4 (VBUS), J1.A9 (VBUS), J1.B4 (VBUS), J1.B9 (VBUS), TP_XUSB0.X
unnamed: J1.A5 (CC1), R3.2
unnamed: J1.B5 (CC2), R4.2
unnamed: RN2.7 (2), RX0.A, TP_RXL0.X (TESTP)
unnamed: RN2.6 (2), TP_TXL0.X (TESTP), TX0.A
unnamed: ON0.A, RN4.5 (2), RN4.6 (2), TP_ONL0.X (TESTP)
unnamed: L0.A, RN2.1, TP_LL0.X (TESTP)

Notes on the sheet:
SCL
USB boot En
SDA
Arduino(TM) UNO Rev3

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
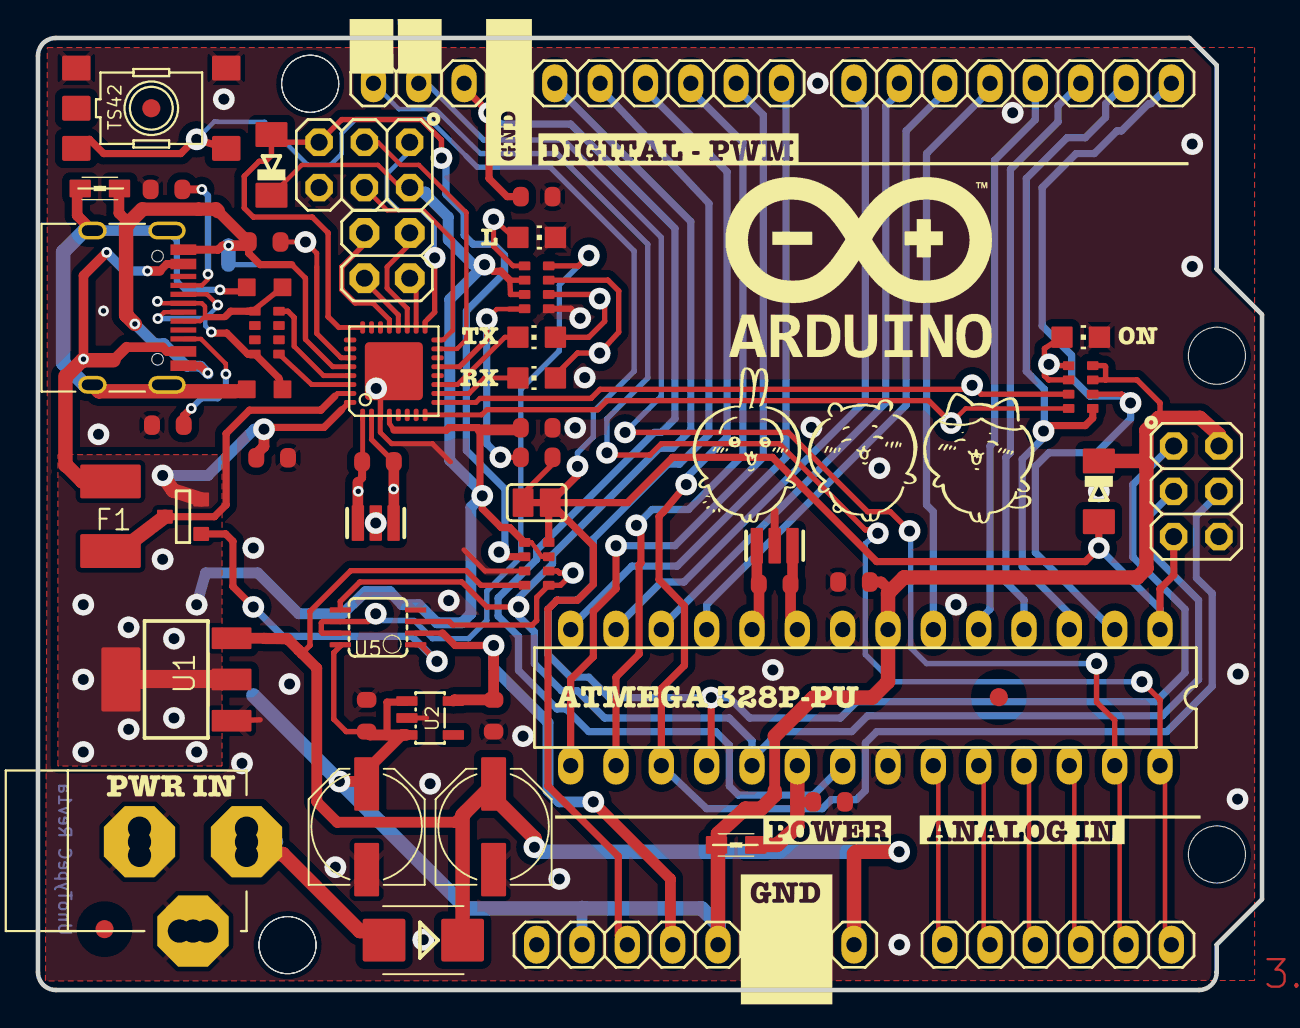
[picture p17: board Hardware/KiCad7xx_UnoTypeC/KiCad7xx_UnoTypeC.kicad_pcb from above]

Board: 2 copper layers, 68.6 x 53.3 mm, 112 parts (1 on the bottom side), 63 nets.

Other parts of the board:
@HOLE0, @HOLE1, @HOLE2, @HOLE3: (no value)
