hirotaka42/KiCad_UnoTypeC/Hardware/Make/KiCad7xx_UnoTypeC.kicad_pcb

## KiCad design Hardware/Make/KiCad7xx_UnoTypeC.kicad_pcb (2023-03-06)

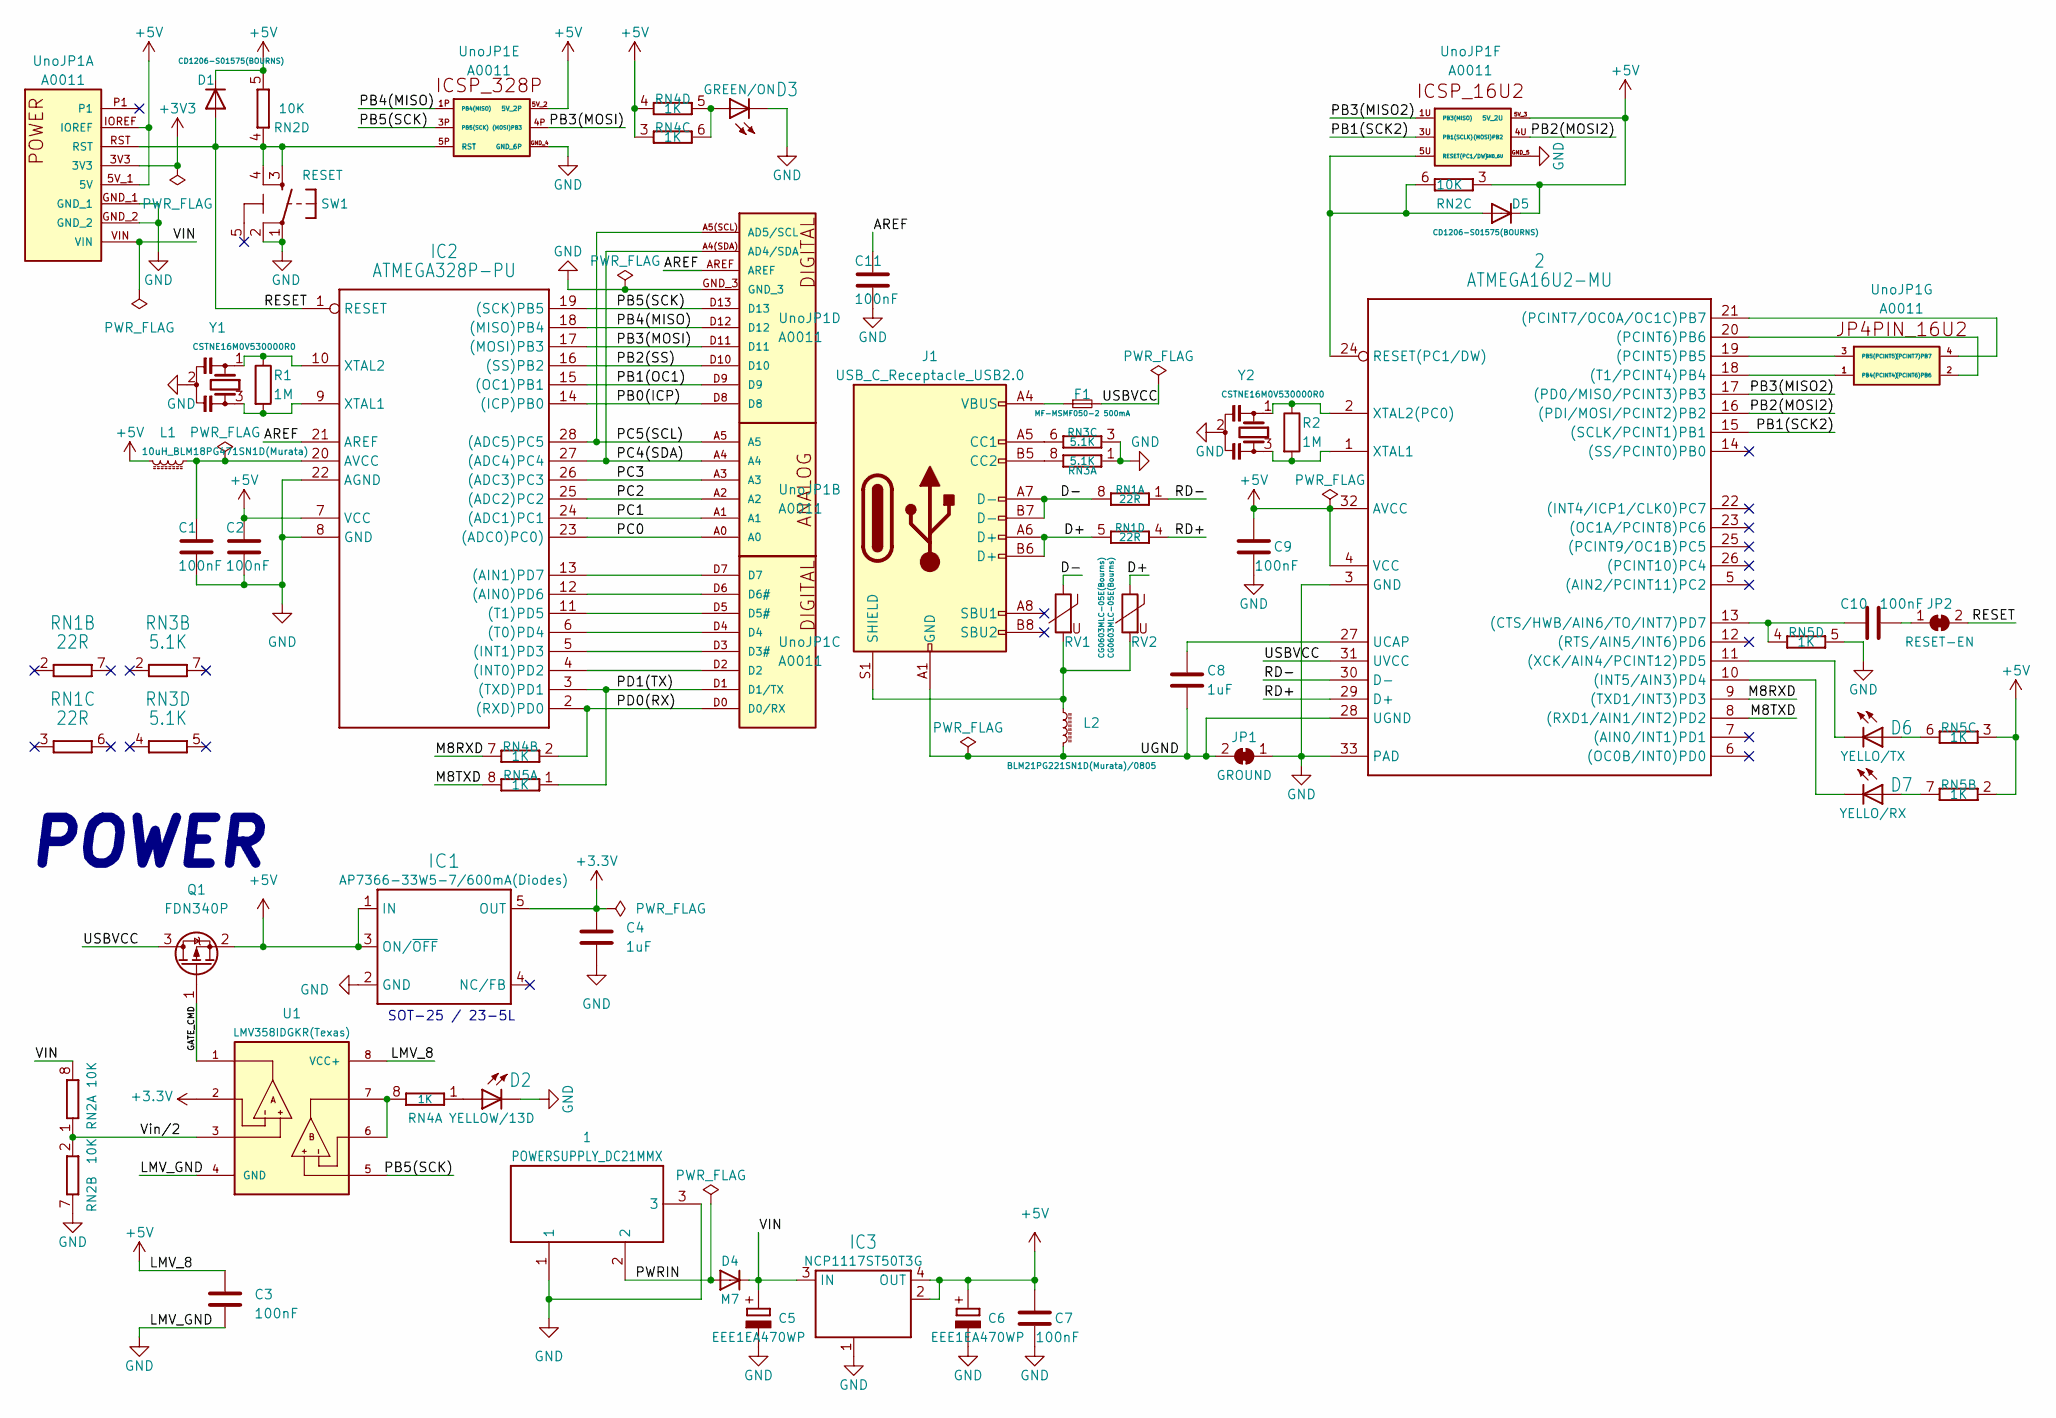
[picture p18: schematic KiCad7xx_UnoTypeC.kicad_sch]

Parts:
1: POWERSUPPLY_DC21MMX; POWERSUPPLY_DC-21MM
2: ATMEGA16U2-MU; MLF32
C1, C2, C3, C7, C9, C10, C11: 100nF; C0603-ROUND
C4, C8: 1uF; C0603-ROUND
C5, C6: EEE1EA470WP; PANASONIC_D
D1, D5: CD1206-S01575(BOURNS); MINIMELF
D2: YELLOW/13D; CHIP-LED0805
D3: GREEN/ON; CHIP-LED0805
D4: M7; SMB
D6: YELLO/TX; CHIP-LED0805
D7: YELLO/RX; CHIP-LED0805
F1: MF-MSMF050-2 500mA; L1812
IC1: AP7366-33W5-7/600mA(Diodes); SOT23-DBV
IC2: ATMEGA328P-PU; DIL28-3
IC3: NCP1117ST50T3G; SOT223
J1: USB_C_Receptacle_USB2.0; USB_C_Receptacle_HRO_TYPE-C-31-M-12
JP1: GROUND; SJ
JP2: RESET-EN; SJ
L1: 10uH_BLM18PG471SN1D(Murata); 0805
L2: BLM21PG221SN1D(Murata)/0805; 0805
Q1: FDN340P; SOT-23
R1, R2: 1M; C0603-ROUND
RN1: 22R; CAY16
RN2: 10K; CAY16
RN3: 5.1K; CAY16
RN4, RN5: 1K; CAY16
RV1, RV2: CG0603MLC-05E(Bourns); CT_CN0603
SW1: RESET; TS42
U1: LMV358IDGKR(Texas); MSOP08; PARTREV X
UnoJP1: A0011; UnoRev3_A0011
Y1, Y2: CSTNE16M0V530000R0; RESONATOR

Connections:
+5V: 2.4 (VCC), 2.32 (AVCC), C2.1, C3.2, C6.+, C7.1, C9.1, D1.C, D5.C, IC1.1 (IN), IC1.3 (ON/~OFF), IC2.7 (VCC), IC3.2 (OUT@1), IC3.4 (OUT), L1.2, Q1.2 (S), RN2.3 (1), RN2.5 (2), RN4.3 (1), RN4.4 (1), RN5.2 (1), RN5.3 (1), U1.8 (VCC+), UnoJP1.5V_1 (5V), UnoJP1.5V_2 (5V_2P), UnoJP1.5V_3 (5V_2U), UnoJP1.IOREF
/AREF: C11.1, IC2.21 (AREF), UnoJP1.AREF
/D+: J1.A6 (D+), J1.B6 (D+), RN1.5 (2), RV2.1
/D-: J1.A7 (D-), J1.B7 (D-), RN1.8 (2), RV1.1
/GATE_CMD: Q1.1 (G), U1.1
/M8RXD: 2.9 ((TXD1/INT3)PD3), RN4.7 (2)
/M8TXD: 2.8 ((RXD1/AIN1/INT2)PD2), RN5.8 (2)
/PB0(ICP): IC2.14 ((ICP)PB0), UnoJP1.D8
/PB1(OC1): IC2.15 ((OC1)PB1), UnoJP1.D9
/PB1(SCK2): 2.15 ((SCLK/PCINT1)PB1), UnoJP1.3U (PB1(SCLK))
/PB2(MOSI2): 2.16 ((PDI/MOSI/PCINT2)PB2), UnoJP1.4U ((MOSI)PB2)
/PB2(SS): IC2.16 ((SS)PB2), UnoJP1.D10
/PB3(MISO2): 2.17 ((PD0/MISO/PCINT3)PB3), UnoJP1.1U (PB3(MISO))
/PB3(MOSI): IC2.17 ((MOSI)PB3), UnoJP1.4P ((MOSI)PB3), UnoJP1.D11
/PB4(MISO): IC2.18 ((MISO)PB4), UnoJP1.1P (PB4(MISO)), UnoJP1.D12
/PB5(SCK): IC2.19 ((SCK)PB5), U1.5, UnoJP1.3P (PB5(SCK)), UnoJP1.D13
/PC0: IC2.23 ((ADC0)PC0)), UnoJP1.A0
/PC1: IC2.24 ((ADC1)PC1), UnoJP1.A1
/PC2: IC2.25 ((ADC2)PC2), UnoJP1.A2
/PC3: IC2.26 ((ADC3)PC3), UnoJP1.A3
/PC4(SDA): IC2.27 ((ADC4)PC4), UnoJP1.A4, UnoJP1.A4(SDA) (AD4/SDA)
/PC5(SCL): IC2.28 ((ADC5)PC5), UnoJP1.A5, UnoJP1.A5(SCL) (AD5/SCL)
/PD0(RX): IC2.2 ((RXD)PD0), RN4.2 (1), UnoJP1.D0 (D0/RX)
/PD1(TX): IC2.3 ((TXD)PD1), RN5.1, UnoJP1.D1 (D1/TX)
/PWRIN: 1.2, D4.A
/RD+: 2.29 (D+), RN1.4 (1)
/RD-: 2.30 (D-), RN1.1
/RESET: D1.A, IC2.1 (RESET), JP2.2 (B), RN2.4 (1), SW1.3, SW1.4, UnoJP1.5P (RST), UnoJP1.RST
/UGND: 2.28 (UGND), C8.2, J1.A1 (GND), J1.A12 (GND), J1.B1 (GND), J1.B12 (GND), JP1.2 (B), L2.2
/USBVCC: 2.31 (UVCC), F1.2, Q1.3 (D)
/VIN: C5.+, D4.C, IC3.3 (IN), RN2.8 (2), UnoJP1.VIN
/Vin/2: RN2.1, RN2.2 (1), U1.3
GND: 1.1, 1.3, 2.3 (GND), 2.33 (PAD), C1.2, C2.2, C3.1, C4.2, C5.-, C6.-, C7.2, C9.2, C11.2, D2.C, D3.C, IC1.2 (GND), IC2.8 (GND), IC2.22 (AGND), IC3.1 (GND/ADJ), JP1.1 (A), RN2.7 (2), RN3.1, RN3.3 (1), RN5.5 (2), SW1.1, SW1.2, U1.4 (GND), UnoJP1.GND_1, UnoJP1.GND_2, UnoJP1.GND_3, UnoJP1.GND_4 (GND_6P), UnoJP1.GND_5 (GND_6U), Y1.2, Y2.2
unnamed: 2.13 ((CTS/HWB/AIN6/TO/INT7)PD7), C10.1, RN5.4 (1)
unnamed: 2.10 ((INT5/AIN3)PD4), D7.C
unnamed: 2.19 ((PCINT5)PB5), UnoJP1.3 (PB5(PCINT5))
unnamed: 2.20 ((PCINT6)PB6), UnoJP1.2 ((PCINT6)PB6)
unnamed: 2.21 ((PCINT7/OC0A/OC1C)PB7), UnoJP1.4 ((PCINT7)PB7)
unnamed: 2.18 ((T1/PCINT4)PB4), UnoJP1.1 (PB4(PCINT4))
unnamed: 2.11 ((XCK/AIN4/PCINT12)PD5), D6.C
unnamed: 2.24 (RESET(PC1/DW)), D5.A, RN2.6 (2), UnoJP1.5U (RESET(PC1/DW))
unnamed: 2.27 (UCAP), C8.1
unnamed: 2.1 (XTAL1), R2.2, Y2.3
unnamed: 2.2 (XTAL2(PC0)), R2.1, Y2.1
unnamed: D2.A, RN4.1
unnamed: F1.1, J1.A4 (VBUS), J1.A9 (VBUS), J1.B4 (VBUS), J1.B9 (VBUS)
unnamed: IC2.12 ((AIN0)PD6), UnoJP1.D6 (D6#)
unnamed: IC2.13 ((AIN1)PD7), UnoJP1.D7
unnamed: IC2.4 ((INT0)PD2), UnoJP1.D2
unnamed: IC2.5 ((INT1)PD3), UnoJP1.D3 (D3#)
unnamed: IC2.6 ((T0)PD4), UnoJP1.D4
unnamed: IC2.11 ((T1)PD5), UnoJP1.D5 (D5#)
unnamed: C1.1, IC2.20 (AVCC), L1.1
unnamed: IC2.9 (XTAL1), R1.2, Y1.3
unnamed: IC2.10 (XTAL2), R1.1, Y1.1
unnamed: J1.A5 (CC1), RN3.6 (2)
unnamed: J1.B5 (CC2), RN3.8 (2)
unnamed: J1.S1 (SHIELD), L2.1, RV1.2, RV2.2
unnamed: C10.2, JP2.1 (A)
unnamed: RN4.8 (2), U1.6, U1.7
unnamed: D3.A, RN4.5 (2), RN4.6 (2)
unnamed: D7.A, RN5.7 (2)
unnamed: D6.A, RN5.6 (2)

Notes on the sheet:
POWER
SOT-25 / 23-5L

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
Board: 2 copper layers, 44 parts (1 on the bottom side), 65 nets, no tracks yet.
