hirotaka42/KiCad_UnoTypeC/Hardware/KiCad7xx_UnoTypeC_SMD/KiCad7xx_UnoTypeC_SMD.brd

## EAGLE design Hardware/KiCad7xx_UnoTypeC_SMD/KiCad7xx_UnoTypeC_SMD.brd (2023-03-07)

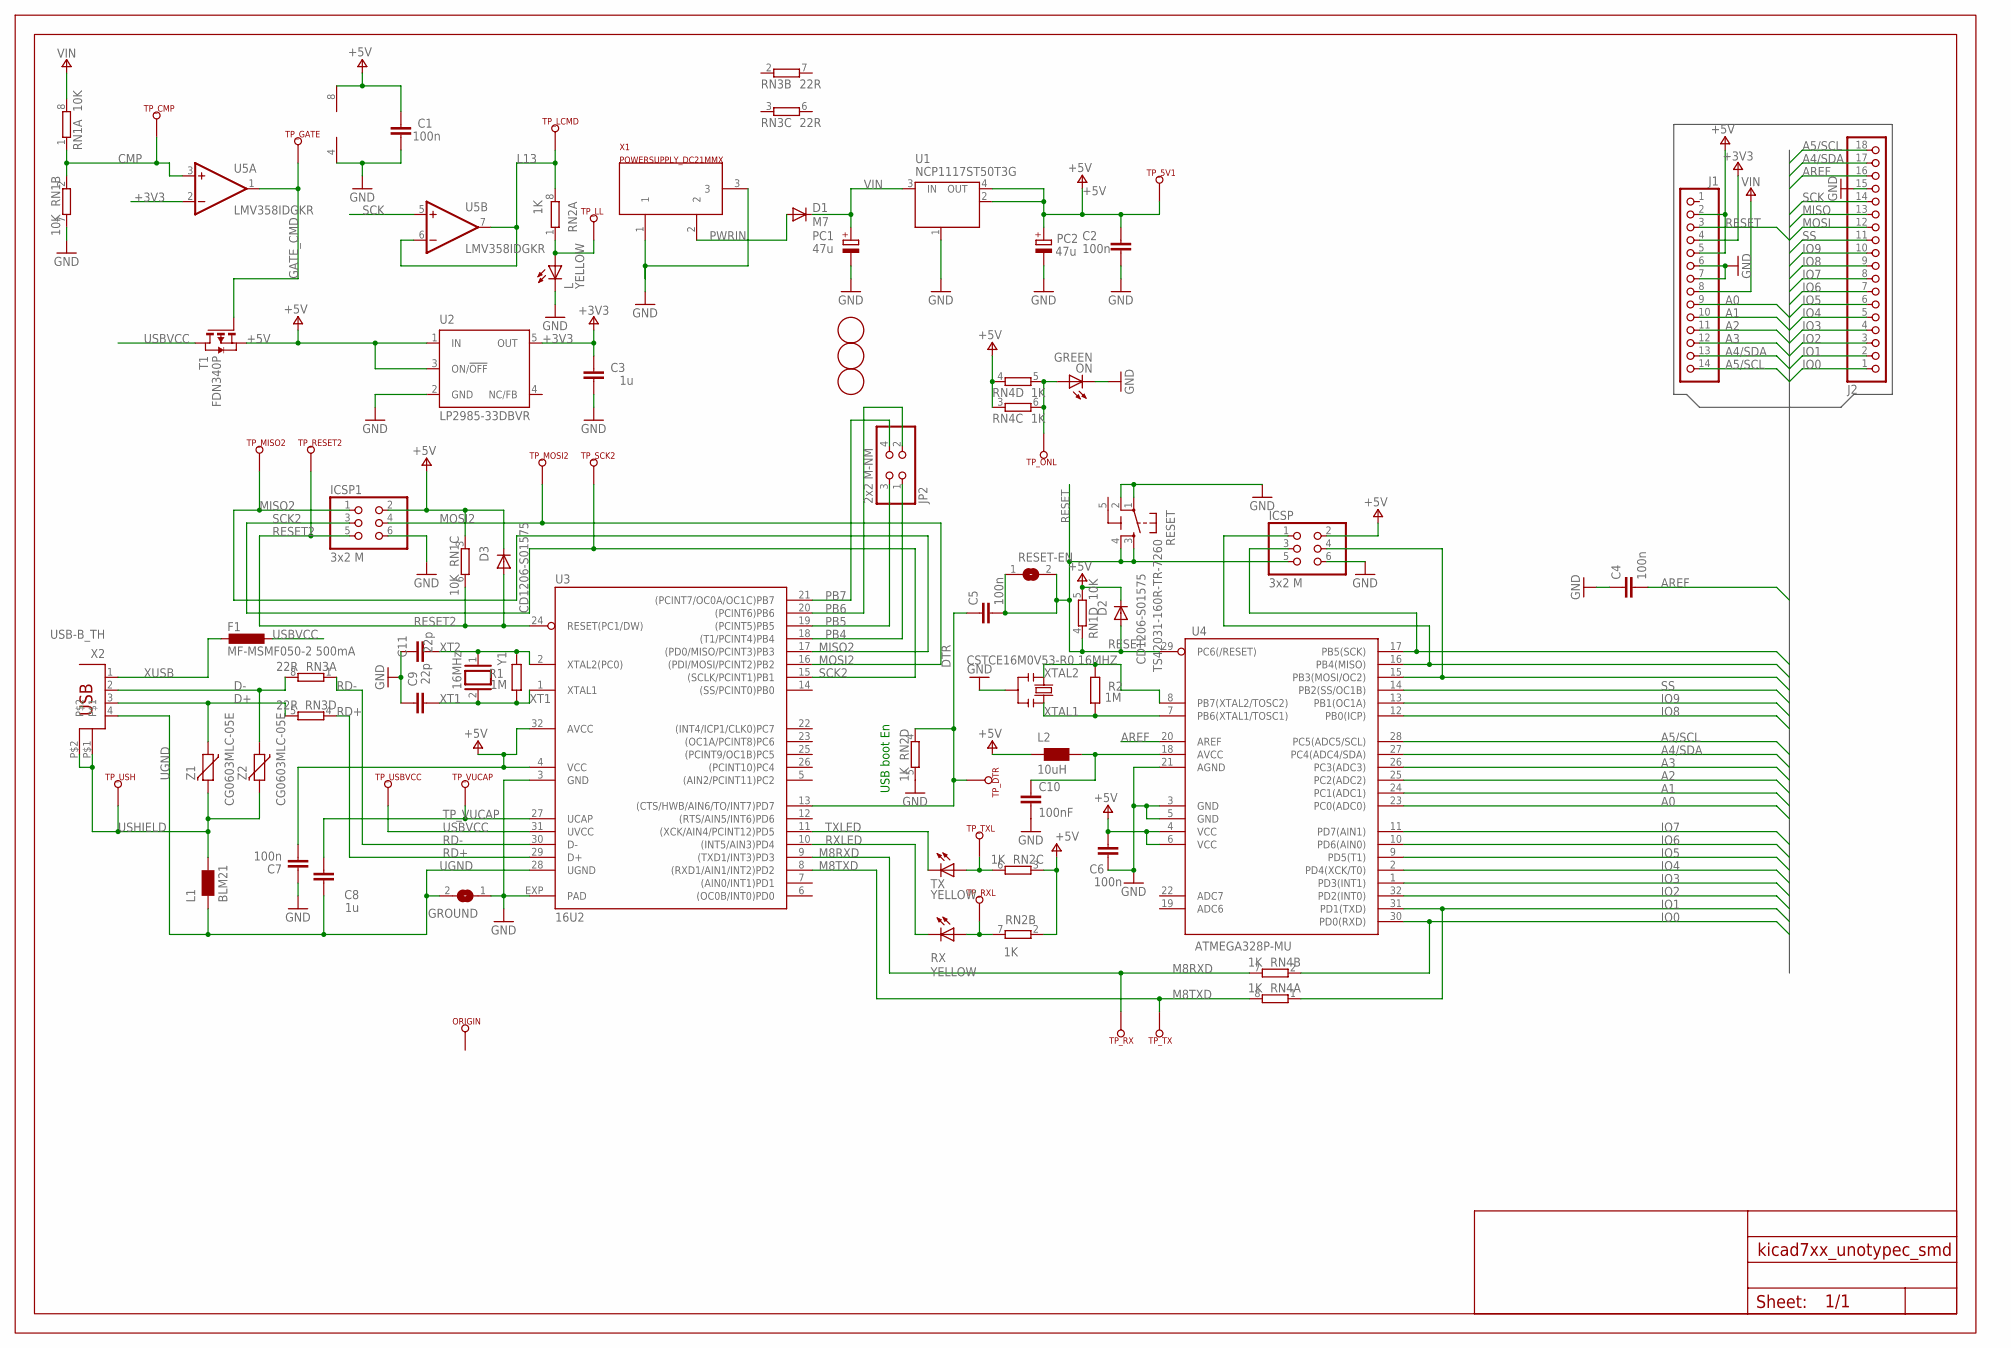
[picture p19: schematic KiCad7xx_UnoTypeC_SMD.sch]

Parts:
C1, C2, C4, C5, C6, C7: 100n; C0603-ROUND
C3, C8: 1u; C0603-ROUND
C9, C11: 22p; C0603-ROUND
C10: 100nF; C0603-ROUND
D1: M7; SMB
D2, D3: CD1206-S01575; MINIMELF
F1: MF-MSMF050-2 500mA; L1812
FD1, FD2, FD3: DNP; FD-1-1.5
FRAME1: DNP; FRAME
GROUND: SJ
ICSP, ICSP1: 3x2 M; 2X03
J1: -; 1X14-CUSTOM
J2: -; 1X18-CUSTOM
JP2: 2x2 M-NM; 2X02
L: YELLOW; CHIP-LED0805
L1: BLM21; 0805
L2: 10uH; 0805
ON: GREEN; CHIP-LED0805
ORIGIN: TP_SP; TP-SP
PC1, PC2: 47u; PANASONIC_D
R1, R2: 1M; R0603-ROUND
RESET: TS42031-160R-TR-7260; TS42
RESET-EN: SJ
RN1: 10K; CAY16
RN2, RN4: 1K; CAY16
RN3: 22R; CAY16
RX: YELLOW; CHIP-LED0805
T1: FDN340P; SOT-23
TP_5V1: TP_SP; TP-SP
TP_CMP: TP_SP; TP-SP
TP_DTR: TP_SP; TP-SP
TP_GATE: TP_SP; TP-SP
TP_LCMD: TP_SP; TP-SP
TP_LL: TP_SP; TP-SP
TP_MISO2: TP_SP; TP-SP
TP_MOSI2: TP_SP; TP-SP
TP_ONL: TP_SP; TP-SP
TP_RESET2: TP_SP; TP-SP
TP_RX: TP_SP; TP-SP
TP_RXL: TP_SP; TP-SP
TP_SCK2: TP_SP; TP-SP
TP_TX: TP_SP; TP-SP
TP_TXL: TP_SP; TP-SP
TP_USBVCC: TP_SP; TP-SP
TP_USH: TP_SP; TP-SP
TP_VUCAP: TP_SP; TP-SP
TX: YELLOW; CHIP-LED0805
U1: NCP1117ST50T3G; SOT223
U2: LP2985-33DBVR; SOT23-DBV
U3: 16U2; ATMEL_QFN32
U4: ATMEGA328P-MU; MLF32
U5: LMV358IDGKR; MSOP08
X1: POWERSUPPLY_DC21MMX; POWERSUPPLY_DC-21MM
X2: USB-B_TH; PN61729
Y1: 16MHz; QS
Y2: CSTCE16M0V53-R0 16MHZ; RESONATOR
Z1, Z2: CG0603MLC-05E; CT/CN0603

Connections:
5-GND: RESET.5 (5-GND)
+3V3: C3.2, J1.4, U2.5 (OUT), U5.2 (-IN)
+5V: C1.2, C2.2, C6.2, C7.1, D2.C, D3.C, ICSP.2, ICSP1.2, J1.2, J1.5, L2.1, PC2.+, RN1.3 (1), RN1.5 (2), RN2.2 (1), RN2.3 (1), RN4.3 (1), RN4.4 (1), T1.2 (S), TP_5V1.X, U1.2 (OUT), U1.4 (OUT), U2.1 (IN), U2.3 (ON/!OFF), U3.4 (VCC), U3.32 (AVCC), U4.4 (VCC), U4.6 (VCC), U5.8 (V+)
A0: J1.9, U4.23 (PC0(ADC0))
A1: J1.10, U4.24 (PC1(ADC1))
A2: J1.11, U4.25 (PC2(ADC2))
A3: J1.12, U4.26 (PC3(ADC3))
A4/SDA: J1.13, J2.17, U4.27 (PC4(ADC4/SDA))
A5/SCL: J1.14, J2.18, U4.28 (PC5(ADC5/SCL))
AREF: C4.2, J2.16, U4.20 (AREF)
CMP: RN1.1, RN1.2 (1), TP_CMP.X, U5.3 (+IN)
D+: RN3.5 (2), X2.3, Z1.1
D-: RN3.8 (2), X2.2, Z2.1
DTR: C5.1, RN2.4 (1), TP_DTR.X, U3.13 ((CTS/HWB/AIN6/TO/INT7)PD7)
GATE_CMD: T1.3 (G), TP_GATE.X, U5.1 (OUT)
GND: C1.1, C2.1, C3.1, C4.1, C6.1, C7.2, C9.2, C10.2, C11.2, GROUND.1, ICSP.6, ICSP1.6, J1.6, J1.7, J2.15, L.C, ON.C, PC1.-, PC2.-, RESET.1, RESET.2, RN1.7 (2), RN2.5 (2), U1.1 (GND/ADJ), U2.2 (GND), U3.3 (GND), U3.EXP (PAD), U4.3 (GND), U4.5 (GND), U4.21 (AGND), U5.4 (V-), X1.1, X1.3, Y2.2
IO0: J2.1, RN4.2 (1), U4.30 (PD0(RXD))
IO1: J2.2, RN4.1, U4.31 (PD1(TXD))
IO2: J2.3, U4.32 (PD2(INT0))
IO3: J2.4, U4.1 (PD3(INT1))
IO4: J2.5, U4.2 (PD4(XCK/T0))
IO5: J2.6, U4.9 (PD5(T1))
IO6: J2.7, U4.10 (PD6(AIN0))
IO7: J2.8, U4.11 (PD7(AIN1))
IO8: J2.9, U4.12 (PB0(ICP))
IO9: J2.10, U4.13 (PB1(OC1A))
L13: RN2.8 (2), TP_LCMD.X, U5.6 (-IN), U5.7 (OUT)
M8RXD: RN4.7 (2), TP_RX.X, U3.9 ((TXD1/INT3)PD3)
M8TXD: RN4.8 (2), TP_TX.X, U3.8 ((RXD1/AIN1/INT2)PD2)
MISO: ICSP.1, J2.13, U4.16 (PB4(MISO))
MISO2: ICSP1.1, TP_MISO2.X, U3.17 ((PD0/MISO/PCINT3)PB3)
MOSI: ICSP.4, J2.12, U4.15 (PB3(MOSI/OC2))
MOSI2: ICSP1.4, TP_MOSI2.X, U3.16 ((PDI/MOSI/PCINT2)PB2)
unnamed: L.A, RN2.1, TP_LL.X
unnamed: ON.A, RN4.5 (2), RN4.6 (2), TP_ONL.X
unnamed: C10.1, L2.2, U4.18 (AVCC)
unnamed: RN2.7 (2), RX.A, TP_RXL.X
unnamed: RN2.6 (2), TP_TXL.X, TX.A
PB4: JP2.1, U3.18 ((T1/PCINT4)PB4)
PB5: JP2.3, U3.19 ((PCINT5)PB5)
PB6: JP2.2, U3.20 ((PCINT6)PB6)
PB7: JP2.4, U3.21 ((PCINT7/OC0A/OC1C)PB7)
PWRIN: D1.A, X1.2
RD+: RN3.4 (1), U3.29 (D+)
RD-: RN3.1, U3.30 (D-)
RESET: C5.2, D2.A, ICSP.5, J1.3, RESET.3, RESET.4, RESET-EN.1, RESET-EN.2, RN1.4 (1), U4.29 (PC6(/RESET))
RESET2: D3.A, ICSP1.5, RN1.6 (2), TP_RESET2.X, U3.24 (RESET(PC1/DW))
RXLED: RX.C, U3.10 ((INT5/AIN3)PD4)
SCK: ICSP.3, J2.14, U4.17 (PB5(SCK)), U5.5 (+IN)
SCK2: ICSP1.3, TP_SCK2.X, U3.15 ((SCLK/PCINT1)PB1)
SS: J2.11, U4.14 (PB2(SS/OC1B))
TP_VUCAP: C8.1, TP_VUCAP.X, U3.27 (UCAP)
TXLED: TX.C, U3.11 ((XCK/AIN4/PCINT12)PD5)
UGND: C8.2, GROUND.2, L1.1, U3.28 (UGND), X2.4
USBVCC: F1.1, T1.1 (D), TP_USBVCC.X, U3.31 (UVCC)
USHIELD: L1.2, TP_USH.X, X2.P$1, X2.P$2, Z1.2, Z2.2
VIN: D1.C, J1.8, PC1.+, RN1.8 (2), U1.3 (IN)
XT1: C9.1, R1.1, U3.1 (XTAL1), Y1.2
XT2: C11.1, R1.2, U3.2 (XTAL2(PC0)), Y1.1
XTAL1: R2.1, U4.7 (PB6(XTAL1/TOSC1)), Y2.3
XTAL2: R2.2, U4.8 (PB7(XTAL2/TOSC2)), Y2.1
XUSB: F1.2, X2.1

Notes on the sheet:
USB boot En

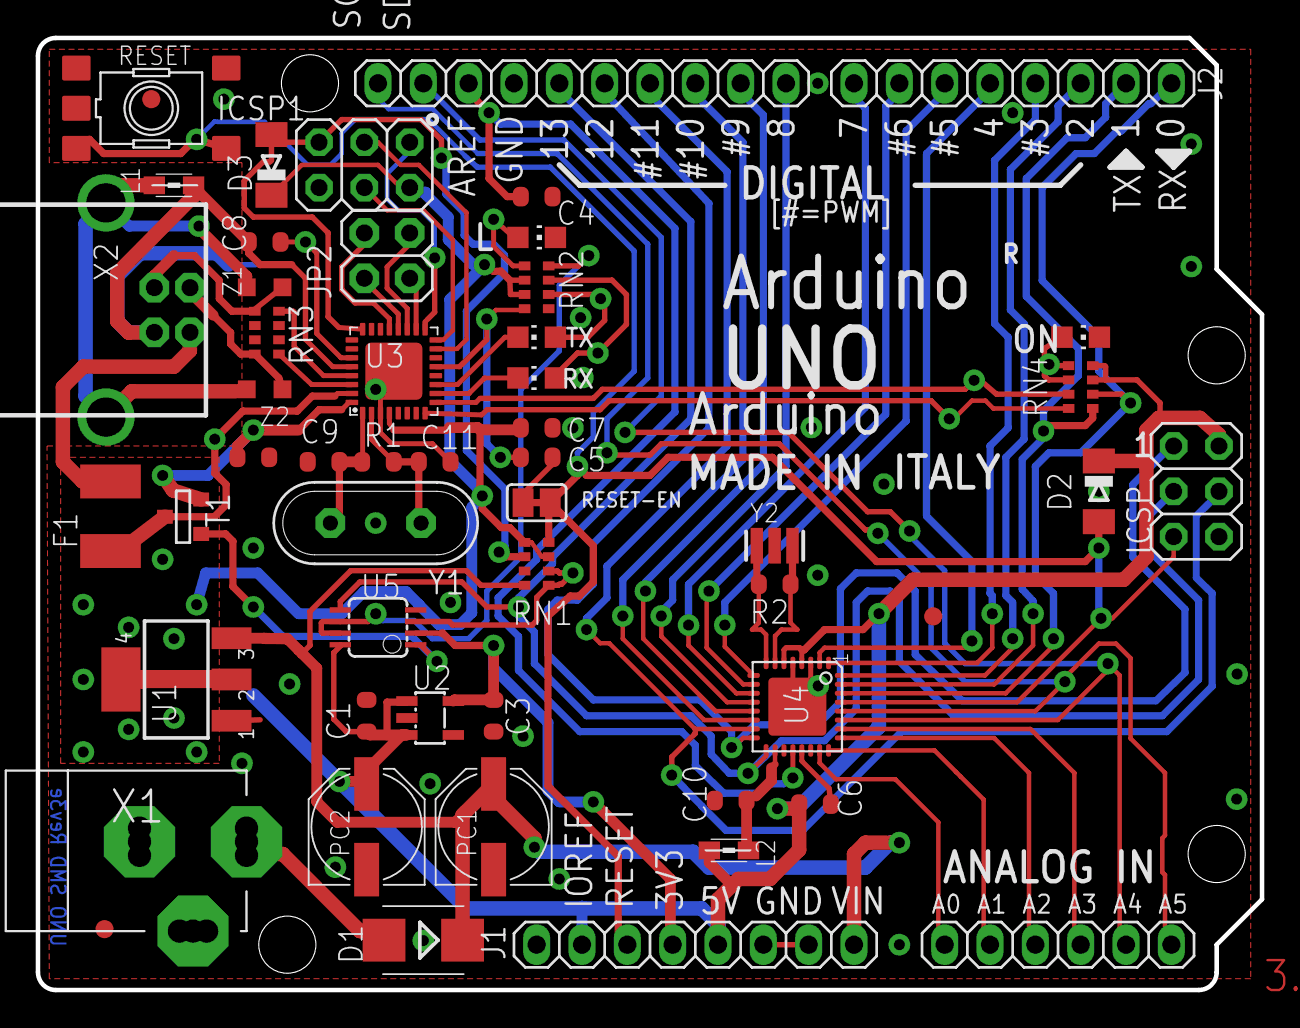
[picture p20: board KiCad7xx_UnoTypeC_SMD.brd from above]

Board: 2 copper layers, 68.6 x 53.3 mm, 72 parts (1 on the bottom side), 61 nets.
