hirotaka42/KiCad_UnoTypeC/(commit log)

2023-03-04 feat: first commit
    [KiCad7_UNO-TH_Rev3e-reference.kicad_pcb, KiCad7_UNO-TH_Rev3e-reference.kicad_sch, UNO-TH_Rev3e.brd, UNO-TH_Rev3e.sch]
2023-03-04 add: .gitignore の追加
2023-03-04 feat: UnoTypeCプロジェクトファイルの新規作成
    [KiCad7xx_UnoTypeC.kicad_pcb, KiCad7xx_UnoTypeC.kicad_sch]
2023-03-04 add: TypeCとリゾネータ部品データの追加
2023-03-06 feat: KiCad7xx_UnoTypeCにて既存のUnoRev3回路図をType-Cに変更
    [KiCad7xx_UnoTypeC.kicad_pcb, KiCad7xx_UnoTypeC.kicad_sch]
2023-03-06 add: PDF-SCHにKiCad7xx_UnoTypeCの回路図を出力
2023-03-06 fix: HRO_TYPE-Cシンボルにて誤ったシンボルが選択されていた為、修正
    [KiCad7xx_UnoTypeC.kicad_sch]
2023-03-06 feat: PCBにTypeCの配線を追加
    [KiCad7xx_UnoTypeC.kicad_pcb, KiCad7xx_UnoTypeC.kicad_sch]
2023-03-07 feat: Gerberとシルクデザインの作成
    [KiCad7xx_UnoTypeC-B_Cu.gbl, KiCad7xx_UnoTypeC-B_Mask.gbs, KiCad7xx_UnoTypeC-B_Silkscreen.gbo, KiCad7xx_UnoTypeC-Edge_Cuts.gm1, KiCad7xx_UnoTypeC-F_Cu.gtl, KiCad7xx_UnoTypeC-F_Mask.gts, KiCad7xx_UnoTypeC-F_Silkscreen.gto, KiCad7xx_UnoTypeC.drl]
2023-03-07 add: UNO-Rev3_SMDをKiCadプロジェクトに変換
    [UNOSMD_V3.brd, UNOSMD_V3.kicad_pcb, UNOSMD_V3.kicad_sch, UNOSMD_V3.sch]
2023-03-07 feat: UnoRev3SMDの作業フォルダの作成
    [KiCad7xx_UnoTypeC_SMD.brd, KiCad7xx_UnoTypeC_SMD.kicad_pcb, KiCad7xx_UnoTypeC_SMD.kicad_sch, KiCad7xx_UnoTypeC_SMD.sch]
2023-03-08 feat: 取り付け穴が消えてしまう為,新たにM3_IOS14580を追加
    [KiCad7xx_UnoTypeC_SMD.kicad_pcb, KiCad7xx_UnoTypeC_SMD.kicad_sch]
2023-03-08 feat: Type-Cコネクタの回路を追加
    [KiCad7xx_UnoTypeC_SMD.kicad_pcb, KiCad7xx_UnoTypeC_SMD.kicad_sch]
2023-03-08 feat: 回路図を見やすくするために変更
    [KiCad7xx_UnoTypeC_SMD.kicad_pcb, KiCad7xx_UnoTypeC_SMD.kicad_sch]
2023-03-08 feat: DCアダプタのシンボルを変更するに伴い,フットプリントの編集
    [KiCad7xx_UnoTypeC_SMD.kicad_pcb]
2023-03-08 feat: 変更した部品のフットプリントを再度配線
    [KiCad7xx_UnoTypeC_SMD.kicad_pcb, KiCad7xx_UnoTypeC_SMD.kicad_sch]
2023-03-09 feat: 電源回路を見直しダイオードSS54B(FOSAN)の追加
    [KiCad7xx_UnoTypeC_SMD.kicad_pcb, KiCad7xx_UnoTypeC_SMD.kicad_sch]
2023-03-10 feat: UnoTypeC_SMD Rev1Cのガーバファイルを作成
    [KiCad7xx_UnoTypeC_SMD-B_Cu.gbl, KiCad7xx_UnoTypeC_SMD-B_Mask.gbs, KiCad7xx_UnoTypeC_SMD-B_Silkscreen.gbo, KiCad7xx_UnoTypeC_SMD-Edge_Cuts.gm1, KiCad7xx_UnoTypeC_SMD-F_Cu.gtl, KiCad7xx_UnoTypeC_SMD-F_Mask.gts, KiCad7xx_UnoTypeC_SMD-F_Silkscreen.gto, KiCad7xx_UnoTypeC_SMD.drl]
