hirotaka42/KiCad_UnoTypeC/(notices)

Notices in the files:
Hardware/KiCad7xx_UnoTypeC_SMD/KiCad7xx_UnoTypeC_SMD.kicad_sch:
This file is licensed under : CC-SA-BY-NC
parts and their libraries:
Arduino-utility: Copyright (c) 2016-2017 Arduino LLC. All right reserved.
